198010ggh-stack/awe_ground/傳感器/HKVL-56六維力/使用筆記.md

# HKVL-56 六維力傳感器使用筆記

日期：2026-11-05
來源：《HKVL-56 型六維力傳感器用戶手冊 Ver 1.1》（蘇州航凱微電子，24 頁 PDF，沒有放進倉庫）和官網產品頁 https://www.hkvtech.cn/archives/172/ 。
讀數腳本：[腳本/hkvl56.py](腳本/hkvl56.py)，已經用手冊裏的全部字節例子自檢通過（`python hkvl56.py --selftest`）。

## 0. 我們手上這個：56C，RS485

| 項目 | 力 Fx/Fy/Fz | 力矩 Mx/My/Mz |
|---|---|---|
| 量程 | 300 N | 10 N·m |
| 分辨率 0.03 %FS | 0.09 N | 0.003 N·m |
| 準度 0.5 %FS | ±1.5 N | ±0.05 N·m |
| 重複精度 0.1 %FS | 0.3 N | 0.01 N·m |
| 過載 300 % | 900 N 不壞（只是不壞，不能拿來測） | 30 N·m |

- **實測（2026-11 第一次通電）：是 Modbus-RTU 版**（第 6.2 節），115200，從機地址 1。不問不答，所以 `--raw` 收不到字節是正常的；讀數要加 `--modbus`。
  - USB 轉 485 模塊是 CH340K，在這臺電腦上是 COM7。
  - 腳本輪詢約 197 Hz，沒有 CRC 錯誤。
  - 空載、剛通電（未預熱）時：零點 Fx +0.12、Fy +0.35、Fz +0.14 N，Mx/My/Mz < 0.007 N·m；噪聲標準差 Fx 0.030、Fy 0.020、Fz 0.017 N，力矩 0.0004–0.0006 N·m。
  - Modbus 版有正式的清零命令，`--hw-zero` 可以用（斷電丟失）。
  - 方向測試和已知重物驗證都通過，讀數準確（重物驗證沒有記錄具體數值）。
- **日常使用**：
  1. 通電，等 30 分鐘預熱，傳感器上不加載。
  2. 在 `腳本/` 目錄下運行 `python hkvl56.py COM7 --modbus`，開頭會自動去皮約 1 秒。
  3. 要記錄數據就加 `--csv 文件名.csv`。
  4. Ctrl+C 停止；斷電前先停腳本。
- 腳本默認 `--model 56C`，屏幕上會一直顯示複合負載率，接近 1 就要減載。
- **在臺架上的位置**：串在線末端和水桶之間，工具端朝上接線，固定端朝下掛水桶。這樣只受拉力，Fz 就是線拉力，10 kg 時負載率約 0.11。為什麼不裝在滑輪座下面、吊板尺寸和裝配順序，見 `機械設計/臺架/文檔/臺架設計文檔_2026-10-30.md` 第 9 節；3D 模型裏有「傳感器特寫」視圖。

## 1. 它是什麼

一個 Ø56 × 22.5 mm 的鋁合金圓餅，底面（**固定端**）裝在不動的結構上，頂面（**工具端**）裝要測力的東西。內部是應變片加解耦矩陣，直接輸出 **Fx Fy Fz（N）和 Mx My Mz（N·m）** 六個數，已經是工程單位，不用自己標定。線纜是不可拆的 4 芯屏蔽線。

| 型號 | Fx/Fy/Fz | Mx/My/Mz | CAN 2.0 每 LSB（力 / 力矩） |
|---|---|---|---|
| 56AS | 50 N | 2 N·m | 0.025 N / 0.001 N·m |
| 56A | 100 N | 5 N·m | 0.050031 / 0.0025 |
| 56B | 200 N | 7 N·m | 0.0981 / 0.00345 |
| 56C | 300 N | 10 N·m | 0.14715 / 0.005 |
| 56D | 400 N | 12 N·m | 0.1962 / 0.006 |

共同參數：準度 0.5 %FS，重複精度 0.1 %FS，分辨率 0.03 %FS，過載 300 %FS，工作溫度 −10 ~ 80 ℃，採樣 100 ~ 1000 Hz（可定制），供電 12 ~ 24 VDC，重量 ≤ 0.2 kg。

**手上這個是哪個型號、哪種通訊**要看標籤或問賣家。下面四種協議只有一種是你這個傳感器出廠燒好的。

## 2. 坐標系

- **Fz+**：垂直於端面，從固定端指向工具端（工具端朝上放時就是向上）。
- **Fx+**：指向**出線口**那一側。
- **Fy+**：按右手系，從頂面看 Fx 逆時針轉 90°。
- **Mx My Mz**：繞對應軸，右手定則（大拇指沿軸正方向，四指方向為正）。
- **實測確認（第一次通電，傳感器平放、按住底座推頂面）：**
  - 往下按頂面中心：Fz −5 ~ −15 N（用力按到 −70 N）。
  - 往出線口方向推頂面側面：Fx +8 ~ +11 N。
  - 往和出線口垂直的方向推：Fy −8.5 ~ −9.2 N，說明那次推的是 −Y 方向。
  - 讀數就是「施加在工具端上的力」在傳感器坐標系裏的分量。
  - 側推 Fx 約 10 N 時 My 約 −0.06 N·m，側推 Fy 約 −9 N 時 Mx 約 −0.08 N·m。按 M = r × F 反推，手推的位置在坐標原點下方 6–9 mm，所以**原點大約在頂面（工具端端面）附近**。算滑輪的力臂 h 時從頂面量起。

## 3. 機械安裝

| | 固定端（底面） | 工具端（頂面） |
|---|---|---|
| 螺栓 | 6 × M3×12 內六角，出廠就埋在傳感器裏，從底面 6 個 Ø3.2 孔伸出來，最多伸出 6 mm；你的底座上要有 6 個深於 6 mm 的 M3 螺紋孔 | 6 × M4 螺紋孔，均布在 Ø48 圓上，你的工具用 M4 螺絲擰上來 |
| 定位銷孔 | 2 × Ø4.02 (+0.03/0) 深 5 | 2 × Ø4 深 4 |
| 其他 | 出線口在側面，有壓線塊 | 中間 Ø24 凸臺 |

- M3 內埋螺栓怎麼擰：用 2.5 mm 內六角扳手從**頂面的 M4 螺紋孔**伸進去（手冊圖 4 的擰緊順序就畫在這 6 個孔上）。所以要先把底座擰好，再裝工具端。
- 尺寸圖側視上的「Max 6.00」標在 M3 螺栓伸出底面的那一頭，是螺栓最多伸出 6 mm。
- M4 孔下面就是 M3 螺栓頭，M4 螺絲不能擰深，先按 4 mm 左右算。
- 以上三條是按手冊的圖推斷的。**買螺絲、打印吊板前用卡尺量一下，或者跟賣家要 STEP 模型。**
- 擰螺栓：先把 6 顆全部擰進去不擰緊，再按**對角順序**擰緊（手冊圖 4 是五角星走法：1 右下 → 2 左上 → 3 右 → 4 左 → 5 右上 → 6 左下）。擰不順就換螺栓，不要硬擰。
- 拆裝時傳感器和設備都要斷電。

## 4. 接線

| 線色 | RS485 版 | CAN 版 |
|---|---|---|
| 紅 | VCC 12–24 V | VCC 12–24 V |
| 黑 | GND | GND |
| 黃 | 485-A | CAN-H |
| 綠 | 485-B | CAN-L |

- RS485：USB 轉 485 模塊的 A 接黃、B 接綠，**模塊的 GND 和電源的 GND 接到一起**（線只有 4 芯，信號地就是電源地）。
- USB 轉 485 模塊自己由電腦 USB 供電，不用另外接電。模塊端子上如果有 5V/VCC，**空着不接**，接電池會把電倒灌進電腦 USB 口。
- 線只有一兩米、115200 時，模塊上的 120 Ω 終端電阻跳線接不接都行；讀數不穩再試着接上。
- CAN：傳感器內部**沒有** 120 Ω 終端電阻，接收端要自己加 120 Ω。
- 接線前先摸一下金屬放靜電；接錯線可能燒傳感器，按顏色接。

**用鋰電池供電**（手冊範圍 12–24 VDC；手冊沒寫極限電壓、電流，也沒寫有沒有反接保護）：

| 電池 | 電壓範圍 | 能不能直接接 |
|---|---|---|
| 3S | 9.0–12.6 V | 不行，大部分時間低於 12 V |
| 4S | 12.0–16.8 V | 可以，放到每節 3.0 V 前都在範圍內 |
| 5S | 15.0–21.0 V | 可以，最穩 |
| 6S（捲線器那塊） | 18.0–25.2 V | 不要直接接：充滿超過 24 V；VESC 回收制動時母線還會再往上衝 |

- 要用 6S 的話，中間加一個 DC-DC 降壓模塊到 12 V 或 15 V，最好是隔離型，把電機的干擾和地線上的噪聲擋在外面。
- 更省事的辦法是單獨一塊 4S 小電池，或者用 PD 充電寶加 PD 誘騙板，設成 12 V、15 V 或 20 V。
- 電池插頭（XT30/XT60）接紅黑線時一定量一下極性；串一個 0.5–1 A 保險絲。

**XT60 電池怎麼接到傳感器（不用焊）：**

```
電池 XT60 母頭 ═ XT60 公頭帶線 ─ 紅 ─ 保險絲 1A ─[WAGO 2 孔]─ 傳感器紅
                                └ 黑 ────────────[WAGO 3 孔]─ 傳感器黑
                                                      └──── 短線 → 485 模塊 GND
傳感器黃 → 485 模塊 A；傳感器綠 → 485 模塊 B（直接擰進模塊的螺絲端子）
```

- 要買：XT60 公頭帶線（14–16 AWG 矽膠線）、WAGO 221-412 和 221-413 各一個（或普通 2 孔、3 孔快速接線端子）、線上保險絲座加 1 A 保險絲、一小段 22–24 AWG 導線。
- 傳感器的線頭不要剪，直接插進 WAGO 或擰進螺絲端子。
- 順序：全部接好、萬用表確認紅線對黑線是正電壓之後，**最後才插電池**；拆的時候先拔電池。
- 公頭帶線沒插電池時兩根線頭不要碰在一起；不用時把 XT60 拔開。

## 5. 上電和清零

1. 第一次上電或很久沒用：**通電 30 分鐘預熱**再測。
2. 清零（把當前讀數設為零點）：硬件清零命令見第 6 節，**斷電就丟**，每次上電都要重新做。
3. 零點會漂，要經常清零。腳本默認開機時平均 200 幀做軟件去皮，比硬件清零方便。

## 6. 通訊協議

### 6.1 RS485 主動發送（出廠默認 115200）

上電後自己一直往外發，不用發命令。每幀 28 字節：

```
53 54 | Fx Fy Fz Mx My Mz（6 個 float32，小端）| CRC 低字節 CRC 高字節
```

- CRC 是 CRC-16/MODBUS，算**前 26 字節**（包括幀頭 53 54）。
- 例：`00 00 48 41` = 12.5，`00 00 58 41` = 13.5。
- 手冊沒寫數據位、校驗位，先按 8N1 試。
- 波特率可選 115200 / 460800 / 1M。115200 下一幀 28 字節 × 10 bit，每秒最多約 410 幀；要 1 kHz 得用 460800 以上。腳本顯示的 Hz 就是實際收到的幀率。

### 6.2 Modbus-RTU 主從模式

主機問一次，傳感器答一次。默認地址看手冊例子是 0x01。

| 操作 | 命令（已含 CRC） |
|---|---|
| 讀六維（0x0003 起 12 個寄存器） | `01 03 00 03 00 0C B5 CF` → 回 `01 03 18` + 24 字節（6 個小端 float）+ CRC |
| 只讀 Fx | `01 03 00 03 00 02 34 0B` |
| 清零（寫 0x000E = 0） | `01 06 00 0E 00 00 E8 09`，回包是原樣回顯 |
| 改地址（寫 0x0000） | `01 06 00 00 00 02 08 0B`（改成 2，立即生效）；地址 0x00 是廣播 |
| 改波特率（寫 0x000A） | 值 2=115200，3=460800，4=921600，5=1M；`01 06 00 0A 00 05 69 CB` 是改到 1M |

寄存器：Fx 0x0003，Fy 0x0005，Fz 0x0007，Mx 0x0009，My 0x000B，Mz 0x000D，每個 float 佔 2 個寄存器，字節順序是小端。

### 6.3 CAN-FD

仲裁域 1 Mbps，數據域 1 Mbps（可 5 Mbps）。上電自動發，每幀數據域 32 字節：6 個小端 float（Fx..Mz）+ 4 字節保留 + UINT32 幀序。

### 6.4 CAN 2.0（標準幀或擴展幀）

1 Mbps，上電自動發，**兩幀一組**，每幀 7 字節，兩幀的幀序字節相同：

```
頭幀：[幀序][AA][Fx 12bit][Fy 12bit][Fz 12bit][0000]
數據幀：[幀序][Mx 12bit][My 12bit][Mz 12bit][0000][FF]
```

- 每個分量是 12 位補碼，範圍 −2047 ~ +2047，乘上第 1 節表裏的系數就是 N 或 N·m。
- 例（56AS）：`4C AA 02 20 06 05 20` + `4C 00 5F FD 00 E0 FF` → Fx 0.85 N，Fy 0.15 N，Fz 2.05 N，Mx 0.005，My −0.003，Mz 0.014 N·m。
- 改參數都發到**廣播 ID 0x321**：`74 00 0A` 改 ID 為 0x0A（下次上電生效）；`0E 00` 清零（立即生效，斷電丟）；`14 00` 用標準幀，`14 01` 用擴展幀。

## 7. 複合載荷：別只看單軸量程

幾個分量同時受力時，手冊給的安全判據是：

```
(Fx/Fx,FS)² + (Fy/Fy,FS)² + (Fz/Fz,FS)² + (Mx/Mx,FS)² + (My/My,FS)² + (Mz/Mz,FS)² ≤ 1
```

**大於 1 就算每個單軸都沒超量程，也可能讓彈性體輕微塑性變形，零點永久漂移。** 一個力只要不是正好壓在中心，就會同時帶來力矩，所以力臂越長越容易超。腳本加 `--model 56C` 會實時顯示這個值。

**如果裝在滑輪下面**（臺架上最後沒這樣裝，見第 0 節；以後地面站要測線的方向時可能用到）：滑輪那一側除了傳感器不能再碰桌子或支架，否則力會繞過傳感器。假設傳感器頂面朝上，滑輪軸在頂面上方 h 處，線水平進、豎直往下（轉 90°），線拉力為 T。傳感器受到：Fz = −T（豎直段往下拉，過中心不產生力矩），Fx = T（水平段），My = T × h。代入公式就是 2 × (T/F_FS)² + (T·h/M_FS)²：

| 工況 | 56AS | 56A | 56B | 56C | 56D |
|---|---|---|---|---|---|
| T = 100 N，h = 20 mm | 9.00 | 2.16 | 0.58 | 0.26 | 0.15 |
| T = 100 N，h = 40 mm | 12.00 | 2.64 | 0.83 | 0.38 | 0.24 |
| T = 100 N，h = 60 mm | 17.00 | 3.44 | 1.23 | 0.58 | 0.38 |
| T = 200 N（衝擊），h = 20 mm | 36.00 | 8.64 | 2.33 | 1.05 | 0.61 |
| T = 200 N（衝擊），h = 40 mm | 48.00 | 10.56 | 3.31 | 1.53 | 0.94 |

結論：
- 100 N 工作載荷：56B 在 h ≤ 40 mm 時夠用，但餘量小；56C 比較穩。
- 200 N 衝擊：只有 56D 在 h ≤ 40 mm 時不超；56C 要把 h 壓到 20 mm 以下才勉強接近 1。
- 不管哪個型號，滑輪軸都盡量貼近傳感器頂面。
- 傳感器裝的方向不一樣（比如側裝）時，按實際方向重新分解再代公式。

## 8. 第一次通電試讀（建議步驟）

1. 傳感器平放在桌上，不加載。
2. 接 24 V 電源（紅/黑），USB 轉 485 接黃 A、綠 B，兩邊 GND 接一起。
3. `pip install pyserial`，再用 `python -m serial.tools.list_ports -v`（或設備管理器）找 485 模塊是 COM 幾。
4. 先看原始字節：`python hkvl56.py COM5 --raw`（腳本自帶，相當於串口助手的十六進制顯示，Ctrl+C 停）：
   - 每行都是 `53 54` 開頭、28 個字節 → 正常，主動發送模式，直接 `python hkvl56.py COM5`。
   - 一行行 32 個亂七八糟的字節，找不到 `53 54` → 波特率不對，跑 `python hkvl56.py COM5 --scan` 自動試 4 種波特率，再用 `--baud` 指定。
   - 一個字節都沒有 → 查供電、A/B 對調、GND；或者是 Modbus 版，`--scan` 也會試 Modbus。
   - 想用圖形界面的串口助手：`pip install comtool` 後運行 `comtool`；設置 115200、8 位數據、無校驗、1 停止位，接收選 HEX，不要發送任何東西。
5. 預熱 30 分鐘後重啟腳本，讓它重新去皮。
6. 驗證方向和數值：
   - 頂面朝上，放一個用行李秤稱過的東西，Fz 應約為 −m × 9.81（壓向固定端，所以是負的）。
   - 從側面往出線口方向推頂面，Fx 應為正。
7. 要存數據加 `--csv log.csv`。

## 9. 手冊裏前後不一致或沒寫清楚的地方

- **工具端螺栓數量**：2.1 節文字寫「3 個 M4」，安裝圖和尺寸圖都是 6 個 M4，按 6 個。
- **官網和手冊不一樣**：官網寫重量 ≤ 0.3 kg、供電 24 V、採樣 150–1000 Hz；手冊寫 ≤ 0.2 kg、12–24 V、100–1000 Hz。供電用 24 V 兩邊都滿足。
- **Modbus 例 4**：標題寫「寫入 ID:1」，數據卻是 `00 02`，實際寫進去的是 2。
- **RS485 主動發送模式**沒寫怎麼清零，也沒寫數據位、校驗位。腳本用軟件去皮；`--hw-zero` 會發 Modbus 清零幀試試，有沒有用看讀數。
- **主動發送和 Modbus 能不能切換**手冊沒寫，應該是出廠固件決定的，問賣家。
- **4.3 節的 Python 示例代碼有 bug**：幀頭不對時不丟字節，會死循環；用了沒定義的變量 `data`；緩衝區超過 28 字節時 `receive_buffer[:-2]` 取錯範圍。不要照抄，用 `腳本/hkvl56.py`。

## 10. 維護

- 經常往復運動的話，定期檢查螺栓有沒有鬆、線纜有沒有磨破。螺栓鬆了斷電換新的。
- 髒了斷電後用酒精棉簽擦。避免高溫高濕、灰塵、液體、溫度劇變。
- 不要敲、不要摔、不要拆。經常用到滿量程的話，定期返廠標定。
- 保修 12 個月（從發貨日算）。售後：Support@hkvtech.cn，13801597531。

## 11. 在 Jetson NX 上運行（不接電腦）

接線不變：USB 轉 485 模塊從電腦換插到 NX 的 USB 口，傳感器照樣單獨 12–24 V 供電，485 模塊的 GND 照樣接傳感器電源負極。腳本支持 Python 3.6 以上，JetPack 4/5/6 自帶的 python3 都能跑。

**我們這臺 NX（2026-11-06 查的）：** JetPack 6，L4T R36.4.4，內核 5.15.148-tegra，用戶 nvidia。這版內核**沒帶 CH340 驅動**（`modinfo ch341` 報 not found），所以 `lsusb` 能看到 `1a86:7522 QinHeng`，卻沒有 `/dev/ttyUSB0`。要先裝驅動。

**一次性設置：**

1. 拷文件：先在 NX 上 `hostname -I` 查 IP，再在 Windows PowerShell 裏進到 `傳感器\HKVL-56六維力\腳本` 目錄：
   `scp hkvl56.py nx_install_ch341.sh nvidia@NX的IP:~/`
2. 在 NX 上裝驅動：`bash ~/nx_install_ch341.sh`（不要加 sudo，中途會要密碼）。
   - 腳本從 kernel.org 下載和內核同版本（v5.15.148）的 `ch341.c`，編譯成 `ch341.ko`，裝到 `/lib/modules/5.15.148-tegra/extra/`，以後插上自動加載。
   - 順便把用戶加進 dialout 組，沒有 pyserial 的話一起裝上。
   - **apt 升級 L4T 內核以後（`uname -r` 變了）要重新跑一次。**
   - 2026-11-06 在這臺 NX 上實際跑通：出現 `/dev/ttyUSB0`，固定名字是 `/dev/serial/by-id/usb-1a86_USB_Serial-if00-port0`。
3. 退出重新登錄（SSH 斷開重連），dialout 權限才生效；`groups` 裏有 dialout 才算好。只想在當前終端先用，可以 `newgrp dialout`。
4. 拔插一次 485 模塊，看串口：`ls /dev/ttyUSB* /dev/serial/by-id/`，應該有 `/dev/ttyUSB0`。
   - 插上一下就消失、`sudo dmesg` 裏有 `brltty`：盲文屏幕閱讀器搶了串口，`sudo apt remove brltty` 後重插。
5. 自檢：`python3 ~/hkvl56.py --selftest`。

**日常運行：**

- `python3 ~/hkvl56.py /dev/ttyUSB0 --modbus`；記錄數據加 `--csv ~/force.csv`（同名文件會被覆蓋）。
- 串口名用 `/dev/serial/by-id/` 下面那個長名字更穩：插別的 USB 串口設備時 `ttyUSB0` 可能變成 `ttyUSB1`，by-id 的名字不變。
- 不接顯示器、SSH 斷了也不停：先 `tmux new -s ft` 再運行；按 Ctrl+B 再按 D 脫離，之後 `tmux attach -t ft` 回來看。沒有 tmux 就 `sudo apt install tmux`。
- 預熱照樣要 30 分鐘；開機自啟時傳感器剛上電，去皮不準，預熱完重啟腳本。

**在自己的程序裏用（NX 上做計算）：** 把 `hkvl56.py` 放在同一目錄，

```python
import serial, hkvl56
ser = serial.Serial("/dev/ttyUSB0", 115200, timeout=0.05)
it = hkvl56.stream(ser, modbus=True)   # 約 200 Hz
zero = hkvl56.tare(it, 200)            # 空載平均 200 幀做零點
for raw in it:
    fx, fy, fz, mx, my, mz = (a - b for a, b in zip(raw, zero))
    # 在這裏算線拉力、寫日誌、發給別的程序……
```
