198010ggh-stack/awe_ground/機械設計/捲線器/文檔/地面手拉測試_2026-11-06.md

# 捲線器地面手拉測試

日期：2026-11-06
範圍：把捲線器放在地上、由人手拉線，給它一個可控的負載，用來標定「電流 → 線拉力」和試測試用的 lisp。代替原來的桌邊臺架（臺架暫不搭建，設計保留在 `機械設計/臺架/`）。捲線器本體見 `捲線器設計文檔_2026-10-20.md`，六維力傳感器見 `傳感器/HKVL-56六維力/使用筆記.md`。

演示：`手拉測試_網頁3D模型.html`（放線 / 8 字飛行 / 收線三種模式切換，實時顯示電流、拉力、線速和功率）；放線模式的動圖 `手拉測試動圖_放線.gif`。

## 1. 和臺架有什麼不同

| | 臺架（不做了） | 地面手拉 |
|---|---|---|
| 負載 | 水桶，重量固定、已知 | 人手，拉力隨人變 |
| 行程 | 約 0.3 m | 5–10 m（放出多少線就有多少） |
| 拉力讀數 | 已知重量 / 行李秤 | 串在線上的六維力傳感器或行李秤 |
| 最大的危險 | 水桶被拉到頂 | **人一鬆手，捲筒加速收線，手柄飛回來** |

所以手拉測試的安全全靠三樣東西：**低電流上限、最高轉速限制、手邊的急停**。三樣都設好之前不要拉。

## 2. 場地和固定

### 2.1 擺放

- 平整的地面，捲線器前方 10 m 長、1 m 寬的通道裏沒有人和雜物。
- 光軸**垂直於**拉線方向，拉線的人站在**捲筒中間的正前方**。沒有排線機構，人一偏，線就堆到捲筒一邊，會蹭擋板邊緣。
- 線**從捲筒下方出來**（離地 59.5 mm），比從上方出來（離地 150 mm）掀翻力矩小一半多。

### 2.2 固定（必須做）

線水平拉捲筒時，會把捲線器往人這邊**拖**，還會往前**掀**：

| 電流 | 線拉力（按 4 N/A 估） | 拖動力 | 掀翻力矩（線高 59.5 mm） |
|---|---|---|---|
| 5 A | 約 20 N | 20 N | 1.2 N·m |
| 25 A | 約 100 N | 100 N | 6 N·m |

捲線器約 4.4 kg：
- 放在地上靠摩擦只能擋住約 17 N 的拖動力，5 A 就快拖動了。
- 重心在前面那根型材外緣後面約 50 mm，自重只能抵約 2.2 N·m 的掀翻力矩。

所以要做兩件事：

1. **防拖動**：用綁帶把兩根型材的後端綁在身後一個重而穩的東西上，比如工作臺的腿或重櫃子。綁帶方向和拉線方向相反，拉緊。
2. **防掀翻**：在電機下面的兩根型材上壓約 10 kg 的東西，比如一摞書或一桶水，放在電機下面的空當裏，別碰到轉子。25 A 時要多抵 3.8 N·m，按 50 mm 力臂需要約 8 kg，10 kg 有餘量。

### 2.3 手的高度

- 線往上斜拉會把捲線器前端往上抬，掀翻力矩更大。
- 拉線的人站在 3 m 以外，手放低，先拉在膝蓋高度，讓線和地面的夾角保持在 20° 以內。

## 3. 線、手柄和拉力讀數

### 3.1 線

- 只放出 5–10 m。捲筒上至少留 3 圈，線頭穿過擋板上的 Ø3 孔打結。
- 測試前檢查線有沒有磨損、打結。

### 3.2 手柄

- 線末端用單套結拴一根木棍當手柄，比如 Ø25 × 300 mm 的木棍或掃把柄。
- **不要把線纏在手上或手指上**。Dyneema 很細很滑，受力時會勒進肉裏。
- 拉線的人戴手套和護目鏡。

### 3.3 拉力讀數：六維力傳感器（推薦）

把臺架設計裏做好的上、下吊板直接拿來用，串在線和手柄之間：

```
線（單套結）→ 上吊板吊耳 → HKVL-56C → 下吊板吊耳 → S 鉤 → 手柄
```

- **線拉力就是 Fz**：只受拉力，Fz 方向從固定端指向工具端。量程 300 N，100 N 時負載率約 0.11；過載 900 N 不壞。
- **傳感器的線纜要留鬆弛**：用紮帶在手柄上固定一段，讓拉力全部走傳感器，不走線纜。
- **電腦和 24 V 電源放在拉線的人身邊**：傳感器線纜長度有限。RS485 可以接長到幾十米，也可以把電腦放在中間。
- **讀數**：在 `傳感器/HKVL-56六維力/腳本/` 下運行 `python hkvl56.py COM7 --modbus`（COM 口以設備管理器為準）。開頭會自動去皮約 1 秒，這時線一定要鬆着。
- 吊板孔位按 Ø48 圓 6 等分估的，打印前先用卡尺核對傳感器，見臺架設計文檔第 9.3 節。

### 3.4 拉力讀數：行李秤（沒有傳感器時）

- 行李秤串在線和手柄之間，只能在人站住不動時讀數。

## 4. VESC 設置（每次測試前確認）

| 參數（VESC Tool 裏的名字） | 設多少 | 為什麼 |
|---|---|---|
| Motor Current Max | 先 3–5 A，以後最多 25 A | 限制最大拉力，3–5 A 約 12–20 N |
| Motor Current Max Brake | 和上面同樣大小 | 人往外拉線時電機在制動 |
| Battery Current Max / Max Regen | 例如 +10 A / −5 A | 往外拉線時電機發電，電流倒灌回電池 |
| Max ERPM | 210 × 電機極對數 | 把線速限制在約 1 m/s（捲筒約 210 rpm）。28 極的電機是 14 對極，約 2940 |
| 電機方向 | 正電流 = 收線 | 反了就在 VESC Tool 裏反轉電機方向，不要改接線 |

- **只用 VESC Tool 手動給電流**，在底部的 Current 輸入框裏輸入。
- **原版的 `vesc-code.lisp` 和 `vesc-code_test.lisp` 都不要刷**，它們在沒有拉力時會一直收線。
- FOC 參數檢測要先做完（捲線器設計文檔第 8 節）。

## 5. 人員分工和口令

- **操作員**：守着電腦和急停。急停是串在電池線上的 XT60 防打火開關。
- **拉線的人**：戴手套和護目鏡，只按口令動作。
- **其他人**：站在捲線器後面或側面，不要站在線的延長線上，也不要跨過線。

口令統一，每一步都等對方回應：

| 口令 | 誰說 | 意思 |
|---|---|---|
| 拉緊 | 操作員 | 拉線的人把線拉直、站穩，回「好」 |
| 給電 X 安 | 操作員 | 輸入 X A |
| 放 / 收 | 操作員 | 拉線的人慢慢後退（放線）或前進（收線），全程保持線是緊的 |
| 零 | 操作員 | 電流設 0。**拉線的人只有聽到「零」之後才能鬆手** |
| 停 | 任何人 | 操作員立刻斷急停 |

## 6. 測試步驟

### 6.1 首次通電（不接線）

1. 斷開線，捲筒上不拴線，或者線全部繞好、線頭固定。
2. 做 FOC 參數檢測。
3. 用 ≤ 2 A 低速轉動：看同心度、聽有沒有異響、看頂絲有沒有鬆，確認正電流是收線方向。
4. 設好第 4 節的限制，特別是 Max ERPM。手撥捲筒轉一下，確認轉速被限住。

### 6.2 1 A 手拉

1. 拴好線和手柄（帶傳感器的話先去皮）。拉線的人走到 3 m 外，把線拉直。
2. 「給電 1 安」：拉線的人感到一個穩定的拉力，約 4 N。
3. 「放」：慢慢後退 2–3 m，線被拉出，電機在制動、發電。
4. 「收」：慢慢往前走，讓電機把線收回來，線始終保持緊的。
5. 「零」，然後再鬆手。

### 6.3 逐步加大

- 每檔手感正常、捲線器沒動、沒有異響，就按 2 A → 3 A → 5 A 往上加。
- 加到 5 A 以上前，先把 Motor Current Max 調高，並再確認一遍固定（第 2.2 節）。
- 每次加檔後，看一眼油漆筆畫的記號線（頂絲、螺母、法蘭）有沒有錯開，立板根部有沒有發白。

### 6.4 標定：電流 → 線拉力

**靜態（主要用這個）**
1. 拉線的人站住不動，線拉直。
2. 操作員依次給 2、4、6 … A，每檔停 3–5 秒。
3. 記錄這段時間 Fz 的平均值；用行李秤時讀穩定的讀數，kg × 9.81。
4. 填第 8 節的表，擬合 T = k × I + b。
   - k 預計 3.6–4.2 N/A（捲線器設計文檔和臺架設計文檔第 6.3 節有推算過程）。
   - Kt = k × 0.0455 m，捲筒上只有幾圈線時用這個半徑。

**看摩擦（有傳感器時）**
1. 固定一個電流（比如 3 A）。
2. 拉線的人以差不多的速度慢慢「放」一段，再「收」一段。
3. 放線時 Fz 比收線時大，兩者差值的一半就是傳動摩擦。原版降落時最低只給 1.7 A，摩擦大了低拉力就控制不准，所以要知道它有多大。

### 6.5 測試用 lisp（以後）

在同樣的條件下試：先 3–5 A、Max ERPM 限住，再逐步放開。lisp 裏要有按線長和線速的保護。

## 7. 什麼情況立刻停

- 拉線的人手滑、摔倒，或者線纏到東西。
- 捲線器被拖動或前端翹起。
- 有異響，記號線錯開（頂絲或螺母鬆了），立板根部或螺栓孔周圍發白、開裂。
- 電機或 VESC 燙手。
- 每次測試結束都要斷開電池。

## 8. 記錄表

| 日期 | 電流 I (A) | 拉力 Fz (N) | 拉力來源（傳感器 / 行李秤） | 放線 / 收線 / 靜止 | 備註 |
|---|---|---|---|---|---|
| | | | | | |
