198010ggh-stack/awe_ground/機械設計/捲線器/文檔/捲線器設計文檔_2026-10-20.md

# 地面站捲線器設計：直驅 + 聯軸器 + 獨立捲筒軸

日期：2026-10-20
範圍：電機與捲線筒的機械連接（捲線器本體）。VESC 配置、lisp 參數、臺架測試架、排線機構不在本文範圍內，另行設計。

## 1. 目標與約束

| 項目 | 取值 |
|---|---|
| 對標 | 原版 KitesForFuture Trampa 165Kv 配置：線拉力係數 ≈ 3.97 N/A，23 A 時約 90 N |
| 電機 | 80100 外轉子，**Kv 50**，Ø12 D 型軸，軸伸出 40 mm（削平段 29 mm），重 1.63 kg |
| 電機安裝 | 定子安裝面與出軸**同側**，4 × M5，孔距圓 **Ø56** |
| 電池 | 現階段 6S；以後上天建議換 12S（結構不受影響） |
| 線 | Dyneema 編織線 Ø1.0 mm，破斷力約 1000 N；現階段 50 m，捲筒容量按 300 m 設計 |
| 工作載荷 | 線拉力 100 N；按 200 N（2 倍衝擊）校核 |
| 加工條件 | 3D 打印（**只有 PLA**）+ 網購標準件；不需要車、銑、鑽 |

## 2. 方案概述

電機直驅，不用減速。電機軸經梅花聯軸器帶動一根 Ø15 捲筒軸。捲筒軸由兩個 KFL002 法蘭軸承支撐，軸承裝在 3D 打印的立板上。

**為什麼直驅**：Kv 50 電機的轉矩常數 Kt ≈ 9.55/50 ≈ 0.19 N·m/A。配上平均有效捲徑 Ø93，線拉力係數 ≈ 0.19 / 0.0465 ≈ **4.1 N/A**，和原版的 3.97 N/A 幾乎一致。如果加 3:1 減速，拉力係數會到約 13.8 N/A，6S 下最大收線速度只有約 1.6 m/s，不可用。

**受力路徑**：
- 線拉力 → 捲筒 → Ø15 軸 → 兩個 KFL002 → 軸承立板 → 鋁型材底座。**電機軸承不承受線拉力。**
- 扭矩 → 捲筒 → 驅動側擋板 → 抱緊式法蘭聯軸器 → Ø15 軸 → 梅花聯軸器 → 電機軸。

## 3. 佈局

所有軸心高度統一取 **H = 85 mm**（從型材頂面量起）。依據：擋板半徑 70 mm + 15 mm 離地間隙；電機半徑 39.5 mm，在這個高度下方留有餘量。

```
側視（沿軸向，x = 0 為電機定子安裝面）
                  立板A(電機)    立板B(軸承1)                       立板C(軸承2)
 ┌──────────┐      ┃  ┌──────┐   ┃[KFL]  [法蘭]┏━┓━━━━━━━━━━━━━━┏━┓  [KFL]┃
 │  80100   ├──────╂──┤聯軸器 ├───╂═══════════════┫ ┣  Ø90 鋁管 L68  ┫ ┣═══════╂══
 │ 轉子殼(轉)│      ┃  └──────┘   ┃              ┃擋┃←4×M5 螺桿→   ┃擋┃       ┃
 └──────────┘      ┃              ┃              ┗━┛━━━━━━━━━━━━━━┗━┛       ┃
 ════════════════ 兩根 2020 鋁型材（長 400 mm）══════════════════════════════════
```

各零件沿軸向的大致位置（x 從電機定子面量起，單位 mm；最終以實物和 CAD 為準）：

| 零件 | x 範圍 |
|---|---|
| 立板 A（電機座，厚 10） | 0 – 10 |
| 電機軸 | 0 – 40 |
| 梅花聯軸器 | 約 14 – 80（隨所買型號的長度變化） |
| 捲筒軸 | 約 56 – 256，長 **200** |
| KFL002 + 立板 B | 約 81.5 – 110（立板 100 – 110；KFL002 內圈伸出 18.5，離聯軸器 1.5 mm） |
| 法蘭輪轂 + 捲筒（含擋板） | 約 120.6 – 209（法蘭盤在鋁管內 141 – 147，輪轂穿過驅動側擋板伸到 120.6） |
| 立板 C + KFL002 | 約 226.5 – 255（立板 226.5 – 236.5；給拉桿螺母和 M6 螺絲頭留間隙，見 4.1、4.4） |

出線方向朝前（垂直於軸），捲筒前方留空，以後裝排線舵機臂和導向環（沿用原版機構，另行設計）。

## 4. 零件設計

### 4.1 立板（共 3 塊，A / B / C）

- 共用一個基礎外形：寬 120 mm，高 H + 40 = 125 mm，厚 10 mm。底部帶 L 形腳板和兩條三角加強筋。腳板上開 2 個 Ø5.5 長孔（每根型材上方一個，可沿軸向調 ±3 mm），用 **M5 × 16** 內六角螺絲 + **M5 加大墊片 + M5 平墊片**（兩片疊用，當墊高）+ 20 系列 M5 T 型螺母（錘頭或彈片式）固定到 2020 型材上。螺絲尖約在型材表面下 5.6 mm，擰進 T 型螺母約 3.8 mm，又不會頂到槽底。
- **打印方向**：兩種都可以。PLA，8 圈壁，60% gyroid 填充，頂底各 6 層。
  - **立着打（推薦，腳板貼平台，和使用時方向一樣）**：佔地 120 × 45，一盤能擺多塊。腳板和立板的連接處在層內，比平放結實。孔變成水平的：Ø40 / Ø36 中心孔頂部會略下垂（只是讓位孔，不影響）；Ø5.5 / Ø6.5 螺絲孔可能略小，螺絲穿不過就用同尺寸鑽頭手擰鉸一下。**不要開支撐**，否則中心孔裏會長滿支撐。
  - 平放（板面貼平台）：佔地 120 × 125；貼電機 / 軸承的那面最平，但腳板和立板的連接處變成層間粘合，是最弱的地方。
- 強度校核：出線垂直於軸、水平朝前，線拉力沿板面方向。200 N 作用在 85 mm 高處，板根彎矩約 17 N·m，10 × 120 截面沿板面彎曲的應力只有約 0.7 MPa。即使線完全從側面拉（極端情況），加上兩條筋板後板根應力約 2.7 MPa，立着打時也遠低於 PLA 層間強度（一般 15–25 MPa）。

**PLA 的三個弱點和對策**（見 4.5 節）：怕熱（約 55 °C 開始變軟）、受恆定載荷會蠕變、受衝擊易脆裂。

**立板 A（電機座）**
- 中心孔 Ø`BOSS_D` = **Ø40**，讓過出軸、中心軸承和定子面上的 4 顆內六角螺絲頭（按電機尺寸圖：孔距約 Ø28、頭約 Ø7，外包絡約 Ø35）。孔邊到 Ø56 安裝孔還剩約 5 mm 料，不用再量實物。
- 4 個 **Ø5.5** 通孔，在 Ø56 孔距圓上，用 M5 螺絲固定電機。
- 板面和轉子殼之間保證 ≥ 2 mm 間隙。只有定子面接觸立板。

**立板 B、C（軸承座）**
- 中心孔 Ø36，讓過 KFL002 的軸承凸台。
- 2 個 Ø6.5 通孔，間距 53 mm，固定 KFL002。
- **緊固件**：M6 × 25 螺絲（推薦外六角，頭高約 4；內六角頭高 6 也可），螺絲頭下墊 M6 平墊片，**從朝捲筒的一面穿入**；M6 普通螺母擰在 KFL002 法蘭那一側（金屬面不用墊片），塗中強度螺紋膠，螺桿伸出螺母約 1.7 mm。
  - 間隙：立板 C 朝捲筒的一面凸出 6 mm 的螺絲頭，必須避開旋轉的拉桿螺母，所以立板 C 外移到 226.5 mm（見 4.4）。立板 B 那側間隙足夠。
- B 板上的 KFL002 裝在朝聯軸器的一面，C 板上的裝在外側面，這樣兩個軸承都在捲筒外側，留出空間給捲筒。

### 4.2 聯軸器

- 梅花聯軸器（鋁合金爪 + 聚氨酯梅花墊），外徑約 D40，孔徑 **12 mm × 15 mm**，頂絲固定型。
- 額定扭矩 ≥ 10 N·m（工作約 4.2 N·m，衝擊約 8.4 N·m）。
- 12 mm 端的頂絲必須壓在電機軸的 D 型削平面上；15 mm 端的頂絲壓在捲筒軸的削平面上。
- 用一個 3D 打印的防護罩蓋住聯軸器，固定在立板 A 和 B 之間的型材上。

### 4.3 捲筒軸

- Ø15 鍍鉻光軸（GCr15），長 200 mm，**整根單邊削平**（削深 1 mm 左右，按店家標準）。
- 兩個 KFL002 用自帶的頂絲鎖住軸，同時限制軸向竄動。
- 撓度校核：軸承跨距約 145 mm，中點受 200 N 時撓度約 0.02 mm，可以忽略。

### 4.4 捲筒

- **芯管**：6061 鋁管，外徑 Ø90，壁厚 3 mm，長 **68 mm**（實測），兩端去毛刺。鋁管承受捲線產生的徑向壓力，打印件不承受。
- **擋板**（2 塊，PLA 打印）：
  - 外徑 Ø140，厚 8 mm。PLA，8 圈壁，60% 填充。打印時槽口朝上（避免第一層外擴把槽口擠窄）。
  - 中心孔：**從動側 Ø15.2**（套在軸上定心，公差片已驗證能順滑通過光軸；AB 膠固化時把捲筒套在光軸上，保證兩端同心）；**驅動側 Ø35.4**（讓法蘭 Ø35 輪轂穿過，並靠輪轂定心，公差片已驗證）。
  - 驅動側另有 **3 × Ø5.5** 法蘭螺栓孔，孔距圓 Ø47.5，對準法蘭上 Ø47.5 那組孔。
  - 內側有一圈環形槽：內徑 83.6、外徑 90.4、**深 4 mm**（槽底剩 4 mm），鋁管兩端插進去。兩塊擋板內側面之間的淨捲線寬度 = 68 − 2 × 4 = **60 mm**。
  - 4 個 Ø5.5 孔，在 Ø70 孔距圓上，給 M5 拉桿用。
  - 1 個 Ø3 的拴線孔，在半徑 48 mm 處（緊貼管面外側）。
- **拉緊**：4 根 M5 304 不鏽鋼全牙螺桿，長 **95 mm**，從管子內部穿過兩塊擋板，兩端各加 1 個 M5 加大墊片（外徑約 15、厚約 1.2）和 1 個 **M5 尼龍防鬆螺母**（厚約 5）。螺母擰緊到擋板剛好夾緊鋁管、不明顯壓陷為止，螺桿兩端伸出螺母各約 3.3 mm，**兩端要一樣長**（見下面的間隙）。
  - 長度計算：兩塊擋板外側面相距 76 mm，加兩端各（墊片 1.2 + 螺母 5 + 伸出 2）= 約 92.4 mm，取 95 mm（每端實際伸出約 3.3 mm）。
  - **間隙**：拉桿螺母、墊片和螺桿端頭隨捲筒旋轉，不能碰到不動的立板 C 和它上面凸出的 M6 螺絲頭。所以立板 C 比最初佈局往外挪約 11.5 mm（朝捲筒面在 226.5 mm 處，見第 3 節）：
    - 拉桿螺母（到 215.2 mm）距 M6 螺絲頭頂（220.5 mm）約 5.3 mm；
    - 螺桿端頭（到 218.5 mm，半徑 32.5–37.5 mm）和螺絲頭（半徑 21.5–31.5 mm）在徑向錯開約 1 mm，不會相碰；
    - KFL002（A0 = 18.5）跟着外移後，內圈末端到軸端只剩約 **1 mm**，裝配時確認內圈的頂絲壓在軸上。
- **防轉（必須做）**：PLA 在恆定夾緊力下會蠕變，螺桿的預緊力會慢慢鬆掉，所以不能只靠摩擦傳扭。**環形槽裏必須塗 AB 膠（環氧樹脂）**，把鋁管和兩塊擋板粘成一體。螺桿只負責定位和輔助夾緊。
- **傳扭**：用標準件「大扭矩法蘭聯軸器－抱緊式」Ø15 孔（法蘭盤 Ø56.8 × 6，輪轂 Ø35，總長 26.4，M4 抱緊螺絲），**反裝**：
  - 法蘭盤放在鋁管裏，用**輪轂那一面**貼住驅動側擋板內側；輪轂穿過擋板的 Ø35.4 中心孔，伸出擋板外側約 12.4 mm，末端離立板 B 約 10.6 mm。這樣 200 mm 的光軸不用加長。
  - 3 顆 **M5 × 25 內六角螺栓**（304）：頭在鋁管裏，穿過法蘭盤 Ø47.5 那組孔和擋板；擋板外側加 M5 平墊片 + M5 尼龍防鬆螺母，以後從外面能檢查螺母鬆緊。**注意**：粘好鋁管後螺栓頭在裏面按不住，擰外面的螺母時螺栓會跟着轉，所以塗膠前先用一點 AB 膠把三顆螺栓頭粘在法蘭盤上。
  - 抱緊螺絲在擋板外側（按商品剖視圖量得，中心距法蘭盤輪轂側端面約 14.1 mm，螺絲頭在擋板外約 2.6 mm），整機裝好後轉動捲筒，還能從側面用內六角扳手擰。軸的**削平面對準抱緊切縫**，抱緊時接觸面最大。孔裏的鍵槽不用。
  - 另一塊擋板只套在軸上定心，不傳扭。
  - **裝配順序**：M5 × 25 的頭在鋁管裏面，必須在塗膠裝鋁管**之前**，先把法蘭和驅動側擋板用螺栓穿好、擰緊。
- **容量**：
  - 50 m 線：捲完外徑約 Ø96，平均有效捲徑約 **Ø93**，捲徑變化約 ±3%。
  - 300 m 線：捲完外徑約 Ø120，Ø140 的擋板還剩約 10 mm 邊。

### 4.5 PLA 打印件的使用限制

| 弱點 | 風險 | 對策 |
|---|---|---|
| 怕熱，約 55 °C 開始變軟 | 立板 A 貼着電機定子面，電機發熱會傳過來；夏天陽光直曬，深色件也會超過 50 °C | 用白色或淺色 PLA；手摸電機殼感覺燙（超過約 50 °C）就停機冷卻；臺架階段電流本來就小，問題不大。**上天前把立板 A 換成鋁板**（外包激光切割 5 mm 鋁板） |
| 蠕變 | 螺栓預緊力隨時間下降，擋板和鋁管之間打滑 | 擋板和鋁管用 AB 膠粘死；所有螺栓加大墊片，分散壓力；每次使用前檢查螺母鬆緊 |
| 脆，受衝擊易裂 | 線拉力突變（陣風、急停）時，立板根部或螺栓孔開裂 | 加強筋取厚 8 mm；螺栓孔周圍靠 8 圈壁加厚；臺架測試時逐步加大電流，每次測完檢查有沒有白痕或裂紋 |

### 4.6 底座

- 兩根 **2020** 鋁型材，各長 400 mm，中心距 80 mm（兩根之間淨空 60 mm）。三塊立板的腳板都橫跨兩根型材，本身就把它們連成一體；兩端可再各夾一根 60 mm 長的 2020 短橫樑，用 20 系列角碼固定，增加剛度（臺架階段可不裝）。
- 臺架階段用 G 字夾把底座固定在桌上；野外使用時再設計地錨接口（不在本文範圍）。

## 5. 採購清單（BOM）

| # | 零件 | 規格 | 數量 | 淘寶搜索關鍵詞 |
|---|---|---|---|---|
| 1 | 電機 | 80100 Kv50 | 1 | （已有） |
| 2 | 鋁管 | 6061，外徑 90 × 壁厚 3，長 68 mm（已到貨實測） | 1 | 6061 鋁管 90×3 零切 |
| 3 | 光軸 | Ø15 GCr15 鍍鉻，長 200，整根單邊削平 | 1 | 15mm 光軸 削平 定制 |
| 4 | 法蘭軸承 | KFL002（孔徑 15） | 2 | KFL002 菱形軸承座 |
| 5 | 梅花聯軸器 | D40 左右，孔徑 12 × 15，頂絲型 | 1 | 梅花聯軸器 D40 12-15 頂絲 |
| 6 | 抱緊式法蘭聯軸器 | 孔徑 Ø15，法蘭盤 Ø56.8 × 6，輪轂 Ø35，總長 26.4；額定扭矩請確認 ≥ 15 N·m | 1 | 大扭矩法蘭聯軸器 抱緊式 15mm |
| 7 | 全牙螺桿 | M5 304 不鏽鋼，長 95 mm | 4 | M5 全牙螺桿 304 |
| 8 | 2020 鋁型材 | 400 mm × 2；短橫樑 60 mm × 2（可選） | 2–4 | 2020 歐標鋁型材 零切 |
| 9 | 角碼 | 20 系列（裝短橫樑時用） | 4–8 | 2020 角碼 |
| 10 | T 型螺母 | 20 系列 M5，錘頭或彈片式 | 約 20 | 2020 錘頭螺母 M5 |
| 11 | M5 螺絲 + 平墊片 | **統一用 M5 × 16 內六角**（304），用墊片調節：電機座 4 顆、立板固定 6 顆，各配平墊片；角碼一般隨附自己的螺絲 | 約 12 顆 + 墊片 12 片 | M5 內六角 16 304、M5 平墊片 |
| 12 | M6 螺絲 + M6 平墊片 + M6 螺母 | M6 × 25 **外六角**，固定 KFL002（捲筒裝上後螺絲頭前只剩 5–11 mm，內六角扳手伸不進去，開口扳手可以） | 4 套 | M6 外六角 25 304、M6 平墊片、M6 螺母 |
| 13 | M5 內六角螺栓 + 平墊片 + 尼龍防鬆螺母 | M5 × 25，304，固定法蘭和驅動側擋板 | 3 套 | M5 內六角 25 304 |
| 14 | M5 尼龍防鬆螺母 + M5 加大墊片 | 拉桿用，304；加大墊片外徑 **≤ Ø15**（和法蘭螺栓的墊片只差約 1 mm） | 8 套 | M5 尼龍防鬆螺母、M5 加大墊片 |
| 15 | PLA 耗材 | 白色或淺色，1 kg（全部打印件實心約 0.97 kg，按 8 圈壁 60% 填充約 0.7–0.8 kg） | 1 | （已有） |
| 16 | Dyneema 線 | Ø1.0 mm，≥ 50 m | 1 | 大力馬 PE 編織線 1.0mm |
| 17 | AB 膠 | 環氧樹脂，固化時間 ≥ 5 分鐘 | 1 | 環氧 AB 膠 |

3D 打印件：立板 A ×1、立板 B/C ×2（同一個模型）、擋板 ×2（從動側中心孔 Ø15.2；驅動側中心孔 Ø35.4，另有 3 個法蘭螺栓孔）、聯軸器防護罩 ×1（未設計）。

### 5.1 緊固件總表（全部 304 不鏽鋼）

| 裝配位置 | 螺絲 / 螺桿 | 墊片 | 螺母 | 套數 |
|---|---|---|---|---|
| ① 電機 → 立板 A（Ø56 孔距，擰進電機螺孔） | M5 × 16 內六角 | M5 平墊片 ×1（按電機孔深增減） | — | 4 |
| ② 立板 A/B/C 腳板 → 2020 型材 | M5 × 16 內六角 | M5 加大墊片 + M5 平墊片（疊用） | 20 系列 M5 錘頭 T 型螺母 | 6 |
| ③ KFL002 → 立板 B、C | M6 × 25 外六角，從朝捲筒一面穿入；**先把 KFL002 裝到立板上再裝捲筒**（捲筒裝上後 25 mm 長的螺絲穿不進去） | M6 平墊片（墊在螺絲頭下，PLA 側） | M6 螺母，擰在 KFL 法蘭側，塗螺紋膠 | 4 |
| ④ 捲筒拉桿（穿過兩塊擋板） | M5 全牙螺桿 L95 | M5 加大墊片（外徑 ≤ 15），每端 1 片 | M5 尼龍防鬆螺母，每端 1 個 | 4 根 |
| ⑤ 抱緊式法蘭 → 驅動側擋板 | M5 × 25 內六角，頭在鋁管內 | M5 平墊片（擋板外側） | M5 尼龍防鬆螺母（擋板外側） | 3 |
| ⑥ 角碼（可選） | 隨角碼套裝 | — | 隨套裝 | — |

隨零件附帶、不用另買：抱緊式法蘭的 M4 抱緊螺絲、梅花聯軸器的抱緊螺絲、KFL002 的鎖軸頂絲。另備中強度螺紋膠（樂泰 243 或同類）。

## 6. 裝配前需要量測並寫回 CAD 的參數

這些參數在 CAD 模型裏做成變量，默認值如下。拿到實物後量一下再出 STL：

| 參數 | 默認值 | 量什麼 |
|---|---|---|
| `BOSS_D` | 40 mm ✔ | 按電機尺寸圖取定：定子面 4 顆內六角螺絲頭外包絡約 Ø35，取 Ø40 留足餘量，不用再量 |
| `MOTOR_SCREW_DEPTH` | 6 mm | 電機 M5 螺孔的深度。**擰太深可能碰到線圈**。統一用 M5 × 16：擰入深度 = 16 − 10（立板）− 墊片厚度，要 ≥ 4 mm 且比孔深少 0.5 mm 以上，用墊片片數來調 |
| 法蘭抱緊螺絲位置 | 約 14.1 mm ✔ | 商品剖視圖量得，滿足 **≥ 12 mm**；輪轂 Ø35、總長 26.4、孔距已按商品圖核對；擋板用法蘭上 Ø47.5 那組孔（已確定） |
| `KFL_SPACING` | 53 mm ✔ | 已按賣家尺寸表確認（J = 53，孔 N = 7，M6） |
| `KFL_BOSS_D` | 36 mm ✔ | 賣家圖：背面（安裝面）平，不凸出；A = 13、A0 = 18.5、法蘭厚 6.5 |
| `TUBE_OD` / `TUBE_ID` / 長度 | 90 / 84 / 68 mm ✔ | 已實測；長 68，所以槽深改 4 mm。公差測試片已驗證：槽能卡住鋁管 |
| `COUPLING_L` | 66 mm | 聯軸器總長，用來確定立板 A 和 B 的間距 |

## 7. 裝配步驟

先統一兩個說法：

- **立板正面**：沒有腳板和加強筋的那一面（平的）。**背面**：有腳板和加強筋的那一面。
- **擋板內側**：有環形槽的那一面。**外側**：平的那一面。

裝好後從側面看（左邊是電機）：

```
        A                    B                                    C
        |                    |                                    |
 [ M ]==|===[ J ]======[ K ]=|==[F][D1]======= tube =======[D2]===|=[ K ]==
        |\                  /|                                    |\
========+---              ---+====================================+---=====
         foot ->        <- foot                                    foot ->
```

M 電機，J 梅花聯軸器，K KFL002，F 法蘭（法蘭盤在鋁管裏，輪轂穿過 D1 朝 B），D1 驅動側擋板，D2 從動側擋板，tube 鋁管，最下面一行是 2020 型材。A 的腳板朝右，B 的腳板朝左，C 的腳板朝右。

### 第一部分：不用 M5×16，現在就能做

**步驟 1　試裝（不塗膠）**

- 光軸能順滑穿過 D2 的中心孔；法蘭輪轂能順滑穿過 D1 的中心孔。
- 鋁管兩端能插進兩塊擋板的槽。
- M5 能穿過 Ø5.5 孔，M6 能穿過 Ø6.5 孔。穿不過就用同尺寸鑽頭手擰鉸一下。

**步驟 2　法蘭裝到 D1**

1. 法蘭盤貼在 D1 內側，輪轂從 D1 的中心大孔穿到外側。
2. 3 顆 M5×25 從內側穿進去，穿過法蘭盤上 Ø47.5 那 3 個孔，再穿過 D1。
3. 外側每顆套一片 M5 平墊片，擰一個尼龍防鬆螺母；用內六角扳手按住螺栓頭擰緊。
4. 在 3 個螺栓頭和法蘭盤之間點一點 AB 膠。這樣以後在外側擰螺母，螺栓不會跟着轉。

**步驟 3　乾裝捲筒（不塗膠，確認能裝上）**

1. 鋁管一端插進 D1 內側的槽，另一端插進 D2 內側的槽。
2. 4 根 M5×95 螺桿穿過兩塊擋板上的 4 個孔（螺桿在鋁管裏面）。
3. 每根螺桿兩端各套一片加大墊片、擰一個尼龍防鬆螺母，兩端露出的長度一樣（約 3 mm）。
4. 能裝上就擰下 D2 這一端的 4 個螺母，取下 D2。

**步驟 4　塗膠固定捲筒**

1. 鋁管兩端用砂紙打毛。
2. 兩塊擋板的槽裏塗 AB 膠，把 D2 裝回去。
3. 光軸上抹一層薄油，從 D1 外側插進法蘭孔，一直穿出 D2 的中心孔。光軸在這裏只當夾具，保證兩塊擋板同心。
4. 4 根螺桿按對角順序一點點擰緊，到擋板貼緊鋁管為止，擦掉擠出來的膠。
5. 放着固化 24 小時，然後抽出光軸。

D2 只靠 8 mm 厚的中心孔套在軸上（孔比軸大 0.2 mm），它正不正全靠鋁管端面和 4 根螺桿；歪 1° 外緣就會擺 ±1.2 mm 左右。在桌上固化看不出它歪沒歪，**更好的做法是塗膠後不在桌上固化**：光軸不抹油，直接按步驟 9、10 裝進捲線器，按步驟 10 第 3 項對正 D2，再讓膠在捲線器上原位固化 24 小時（期間不要轉捲筒）。

**步驟 5　KFL002 裝到立板 B、C（等膠乾的時候做）**

1. KFL002 的平底面貼在立板背面，中心對準立板的中心孔。
2. 2 顆 M6×25 外六角從立板正面穿入（螺絲頭下墊 M6 平墊片），穿過立板和 KFL002 的兩個耳朵孔。
3. KFL002 那一側擰 M6 螺母，塗螺紋膠擰緊。
4. B、C 兩塊做法完全一樣。

### 第二部分：M5×16 到了再做

**步驟 6　電機裝到立板 A**

1. 電機出軸的那一面貼在立板 A 正面，軸從中心孔穿到背面。
2. 轉動電機，讓 4 個螺孔對準立板上的 4 個孔，同時讓電機線朝下或朝側面。
3. 4 顆 M5×16 各套一片平墊片，從立板背面擰進電機，塗螺紋膠。

**步驟 7　聯軸器套到電機軸上**

1. 梅花聯軸器分成三件：12 mm 孔那半、梅花墊、15 mm 孔那半。
2. 12 mm 那半套到電機軸上，頂絲對準軸上的削平面，電機軸端和聯軸器端面齊平，塗螺紋膠擰緊頂絲。
3. 梅花墊和 15 mm 那半套上去，15 mm 那半的頂絲先不擰。

**步驟 8　立板裝到型材上**

1. 兩根 400 mm 型材平行擺放，中心距 80 mm；每根型材槽裏放 3 個 T 型螺母。
2. 按上面的圖擺三塊立板：A 腳板朝右，B 腳板朝左，C 腳板朝右。型材左端比 A 的正面多出約 110 mm，放電機。
3. 間距：A 正面到 B 正面 110 mm；B 正面到 C 正面 116.5 mm。
4. 每塊腳板 2 顆 M5×16，先套加大墊片、再套平墊片，擰進 T 型螺母。
5. B、C：用角尺靠住立板正面和型材，把立板立直、間距對好，然後擰緊腳板螺絲。用手推立板頂端應該推不動。A 先輕輕擰上，還要能滑動。

KFL002 的軸承是調心的，光軸不會把立板扶正，立板豎不豎直只靠腳板。所以 B、C 的腳板一定要在擰 KFL002 頂絲**之前**擰緊；反過來做，腳板位置和光軸鎖定的距離差一點，立板就會被拉歪。

**步驟 9　裝捲筒和光軸**

1. 捲筒放在 B、C 之間，D1（法蘭那頭）朝 B。
2. 光軸從 C 的右側插入，依次穿過：C 上的 KFL002 → D2 → 法蘭 → B 上的 KFL002 → 聯軸器 15 mm 那半。
3. 光軸右端比 C 上 KFL002 的內圈多出約 1 mm。這時光軸應該能在兩個 KFL002 裏輕鬆推動；推不動就是 B、C 的間距或高度不對，先回去查立板。
4. 轉動兩個 KFL002 的內圈，讓其中一顆頂絲對準削平面，擰緊。擰的時候不要推拉光軸和立板。光軸現在固定了。

**步驟 10　固定捲筒**

1. 左右推捲筒，調到：D2 外側的螺桿頭離 C 的 M6 螺絲頭約 2 mm，D1 外側的螺母離 B 的 M6 螺絲頭約 10 mm。
2. 轉動捲筒，讓法蘭輪轂上的切縫對準光軸的削平面，擰緊輪轂上的 M4 抱緊螺絲。
3. 檢查擺動：一支筆用膠帶固定在型材上，筆尖離 D2 外側面靠外緣處約 1 mm，慢慢轉捲筒，一圈下來間隙變化不超過約 0.5 mm。超了就趁膠沒乾，在間隙最小的位置把最近那根螺桿 D2 這頭的螺母擰緊約 1/8 圈，反覆調。D1 也晃的話，先查法蘭盤是否平貼 D1，或者把法蘭在軸上轉 90°/180° 再夾緊，挑擺動最小的位置。

**步驟 11　對好聯軸器**

1. 把立板 A（連電機）往右推，讓 12 mm 那半的爪插進梅花墊。用角尺把 A 立直，擰緊 A 的 2 顆腳板螺絲。
2. 沿光軸推 15 mm 那半，讓梅花墊兩邊各留約 1 mm 間隙。不要把梅花墊壓緊，否則電機會通過光軸把 B、C 頂歪。
3. 擰緊 15 mm 那半的頂絲（壓在削平面上，塗螺紋膠）。

**步驟 12　檢查**

1. 用角尺再看一遍三塊立板，都要豎直。
2. 用手轉捲筒幾整圈：要順滑、沒有異響，轉動的零件不碰任何不動的零件，重點看 C 這邊的螺桿頭和 M6 螺絲頭。
3. 用油漆筆在法蘭和軸、各頂絲、各螺母上畫一條線，以後一眼就能看出有沒有鬆。
4. Dyneema 線穿過擋板上的 Ø3 小孔打結，手轉捲筒先繞幾圈。

## 8. 使用前須知（安全）

- **在手拉測試的電流、轉速限制設好，測試用的 lisp 準備好之前，不要用原版 `vesc-code.lisp` 帶動這個捲線器**（見 `地面手拉測試_2026-11-06.md`）。 原版代碼在沒有線拉力時會以 8–20 A 的電流全力收線，空載時捲筒會飛車（6S 下收線速度約 5 m/s，12S 下約 10 m/s）。
- 首次通電只用 VESC Tool 手動給小電流（≤ 2 A）低速轉動，檢查同心度、異響，以及頂絲有沒有鬆動。
- 轉子殼會外露旋轉。測試時要保持手和線遠離電機，以後再加轉子防護罩。
- 新電機必須在 VESC Tool 裏重新做 FOC 參數檢測。

## 9. 後續（不在本文範圍）

1. 地面手拉測試：捲線器放地上、人手拉線，標定「電流 → 線拉力」，步驟見 `地面手拉測試_2026-11-06.md`。原來的桌邊臺架暫不搭建，設計保留在 `機械設計/臺架/文檔/臺架設計文檔_2026-10-30.md`。
2. VESC 配置（`si_gear_ratio = 1`，`si_wheel_diameter` 按實測有效捲徑）和 lisp 閾值修改（配合 50 m 線）。
3. 排線舵機臂和導向環。
4. 野外地錨接口。
