198010ggh-stack/awe_ground/機械設計/臺架/文檔/臺架設計文檔_2026-10-30.md

# 捲線器臺架測試架：滑輪座裝在捲線器上 + 水桶

日期：2026-10-30（v2：2026-11-01）

> **狀態（2026-11-06）**：老師要求改成把捲線器放在地上、用手拉線測試，**臺架暫不搭建**，本文保留作記錄。第 9 節的六維力傳感器和上、下吊板可以直接用在手拉測試上：串在線和手柄之間測線拉力。

範圍：在桌上測試捲線器用的架子、掛重物的方法和標定步驟。臺架專用 lisp、VESC 配置不在本文範圍內，另寫。捲線器本體見 `機械設計/捲線器/文檔/捲線器設計文檔_2026-10-20.md`。

## 0. v2 改了什麼

v1 的滑輪放在離捲筒 250 mm 的桌邊，所以要用兩根 2020 橫樑和四個角碼把滑輪座接回捲線器，F 夾還要從桌外伸進來 60 mm 夾橫樑；重物用槓鈴片和 M12 掛桿。要買的東西有 13 項。

v2 把滑輪座直接頂在捲線器近桌邊那根型材的外側面上，滑輪架在桌邊上方：

| | v1 | v2 |
|---|---|---|
| 滑輪座固定 | 2 根橫樑 + 4 個角碼 + 2 個 F 夾 | 2 顆 M5 擰進捲線器型材的側槽 |
| 擋線銷 | M4 × 45 螺栓 | 打印的 Ø5 擋線梁 |
| 重物 | 槓鈴片 + M12 掛桿 + D 形扣 | 水桶裝水，行李秤稱重 |
| 要買的 | 13 項 | 608ZZ × 2、M8 螺栓一套；建議加一個防打火開關 |
| 行程 | 約 0.4–0.5 m | 約 0.3 m |
| 滑輪 | Ø52 V 槽打印件 | 不變 |

## 1. 目標與約束

| 項目 | 取值 |
|---|---|
| 用途 | ① 標定「電流 → 線拉力」；② 讓臺架 lisp 帶載低速收放線 |
| 拉力範圍 | 0 – 約 100 N（10 kg 水；原版 lisp 最大 23 A ≈ 95 N） |
| 行程 | 約 0.3 m（桌高 750 mm、10 L 水桶時） |
| 速度 | 低速，≤ 0.2 m/s（捲筒約 42 rpm） |
| 安裝 | 結實的桌子邊；不夾、不打孔 |
| 加工條件 | 3D 打印（PLA）+ 網購標準件；不需要鑽孔 |
| 已有 | 手提行李秤（稱水桶，以及方法 1 的讀數） |

## 2. 佈局

順着光軸看（桌面以下的高度不按比例）：

```
              捲筒（軸心離桌邊 85、離桌面 105）
                .-"""-.
               (   +   )
                '-._.-'
                   \______________ 線，離桌面 59.5
  [R2]     [R1][滑輪座](◎)         滑輪軸心：離 R1 外側面 30、離桌面 39
 ═════════════════ 桌面 ═══╗ │     線在桌邊外約 16 mm 處往下
                           ║ │
                           ║ [水桶]
                         地面鋪墊子
```

- 捲線器的兩根型材和桌邊平行。近桌邊的叫 R1，遠的叫 R2。**R1 外側面離桌邊 35 mm**，也就是捲筒軸心離桌邊 85 mm。
- 滑輪座的立邊貼住 R1 外側面，2 顆 M5 擰進 R1 側槽裏的錘頭 T 型螺母；兩側腳板壓在桌面上，**前沿和桌邊齊平**。滑輪座的前沿就是擺放時的基準。
- **線從捲筒下方出來**，水平走 80 mm 到滑輪。線高 = 型材 20 + 軸高 85 − 捲筒半徑 45.5 = **59.5 mm**（以桌面為 0）。滑輪槽頂接住這根線，線轉 90° 在桌邊外約 16 mm 處往下，吊一桶水。
- 滑輪座可以沿 R1 的側槽滑動。裝好後讓滑輪槽對準線在捲筒上實際纏繞的位置；臺架上線只繞幾圈，這個位置基本不動。
- 測試只用一段約 **1.5 m** 的 Dyneema Ø1 線，不用 50 m 線：出事時捲筒能收回的線很少。

### 2.1 對桌子的要求

- **桌邊平直**：不能有凸出的邊條，線在桌邊外只有約 16 mm。
- **掛水桶的地方下面是空的**：水桶直徑約 26 cm，有一大半在桌面下方，那裏不能有桌腿、抽屜或橫檔。
- **桌子夠穩**：普通書桌、實驗臺都行；很輕的摺疊桌不行。
- **桌子越高行程越長**：桌高 750 mm、10 L 水桶時行程約 0.3 m。

## 3. 零件設計

### 3.1 滑輪（打印 1 個，和 v1 相同）

| 項目 | 取值 |
|---|---|
| 外徑 / 寬 | Ø52 / 15 |
| 槽 | 90° V 槽，深 6，槽底 Ø40；兩側輪緣各剩 1.5 mm 平面 |
| 軸承孔 | 兩側各一個 Ø22.0 × 7 深，各壓一個 608ZZ |
| 中間擋肩 | 兩個軸承孔之間留 1 mm 厚的擋肩，孔 Ø19，只頂軸承外圈 |
| 打印 | 軸線朝上平放；90° 槽的斜面正好 45°，不用支撐 |

- 線在 V 槽底，中心離軸約 20.7 mm。
- 軸承孔 Ø22.0 按公差片的經驗應該是緊配（Ø15.2 孔能順滑通過 Ø15 軸，說明孔基本不縮）。壓不進就用砂紙或鉸刀修，太鬆就點一點 AB 膠。

### 3.2 滑輪座 v2（打印 1 個）

坐標：x 從 R1 外側面朝桌外（桌邊在 x = 35），y 沿桌邊，z 從桌面往上。打印時底面朝下，不用支撐。

| 項目 | 取值 |
|---|---|
| 立邊 | x 0 … 8，y ±50，高 20（和型材一樣高）；貼住 R1 外側面 |
| 立邊螺絲孔 | 2 個 Ø5.5，水平，在 y = ±40、z = 10（R1 側槽中心） |
| 腳板 | x 8 … 35，y ±16.3 … ±31，厚 8；前沿和桌邊齊平 |
| 側板 | 厚 8，兩片之間淨距 **16.6**（滑輪 15 + 兩邊凸台各 0.8）；x 0 … 58，z 0 … 69 |
| 側板之間 | 底下是空的，滑輪從下面裝進去 |
| 滑輪軸孔 | Ø8.4，中心 **x = 30、z = 39** |
| 凸台 | 兩片側板內側，圍着軸孔，Ø11 × **0.8** 高，只頂軸承內圈 |
| 擋線梁 | 打印的 Ø5 橫梁，連着兩片側板，在滑輪軸斜上方、朝桌外 45°，離軸心 29.3（x = 50.7、z = 59.7） |

- **軸心高度**：線心離軸 20.7，捲筒上的線高 59.5，所以軸心 z = 39（線在滑輪上高 59.7，差 0.2 mm，可忽略）。
- **滑輪位置**：滑輪最靠型材的一點在 x = 4，最低點離桌面 13 mm，下面是空的；滑輪離立邊上角最近處約 3 mm。
- **凸台高 0.8 而不是更高**：滑輪側面和側板之間的縫只有 0.8 mm，比線徑 1 mm 小。萬一線跳出槽，也卡不進側縫。
- **擋線梁**：表面離輪緣只有 0.8 mm，線擠不出去。位置在線包住的那 90° 弧中間，不擋進線也不擋出線。打印時是一段 16.6 mm 長的橋接，沒問題。
- **腳板只到 y ±31**：M5 頭下的 Ø15 加大墊片在 y = 40 ± 7.5，腳板要讓開；內六角扳手也從這裏水平伸進去。
- **立邊螺絲**：2 顆 M5 × 16，和捲線器腳板一樣疊 M5 加大墊片 + M5 平墊片（疊起來約 10.2 mm，螺絲尖不會頂到型材槽底），擰進 R1 側槽的錘頭 T 型螺母。錘頭 T 型螺母能從槽口直接放進去再轉 90°，捲線器不用拆。

### 3.3 掛水桶

```
線末端單套結（布林結）→ 水桶提手
```

- 約 10 L 的水桶，加減水調重量，每次用行李秤**連桶帶水一起稱**。比槓鈴片一檔 1.25 kg 更細。
- 線直接打結拴在提手中間。提手上方的線上穿一小塊海綿，水桶被拉到頂時先撞海綿。
- 地上鋪舊靠墊或紙箱接住水桶。
- 想要更長的行程，可以把幾瓶水裝在布袋裏代替水桶：布袋比水桶矮。

### 3.4 受力校核

- **線的水平拉力**：捲筒和滑輪都裝在捲線器上，水平拉力 T 由「捲筒軸 → 立板 → R1 → 滑輪座」自己抵消，不傳給桌子，所以不需要夾。
- **會不會被掀翻**：桌子只承受吊着的重量。10 kg（98 N）在桌邊外約 16 mm 往下，對桌邊的掀翻力矩約 1.5 N·m。捲線器約 4.4 kg（估算），重心在桌邊內約 85 mm，回正力矩約 3.7 N·m，**不夾也翻不了**，餘量約 2.4 倍。保險起見，在電機下面的型材上壓兩本厚書，防止碰到時滑動。
- **滑輪座受力**：滑輪上的合力約 1.41 T，斜向桌內下方，作用線經過滑輪軸，在 x ≈ −9 處穿過桌面，也就是在 R1 底下。滑輪座被壓向 R1 和桌面，2 顆 M5 只負責定位，基本不受力。
- **M8 軸在 PLA 孔裏**：100 N 時合力 141 N，兩片側板分擔，孔壁擠壓應力約 1 MPa，遠小於 PLA 強度。
- **立板**：線拉力水平、垂直於光軸，是捲線器設計時校核過的方向（沿板面受力，見捲線器設計文檔 4.1）。

## 4. 物料清單

**打印件**（PLA，參數和捲線器打印件一樣：8 圈壁、60% 螺旋體填充、頂層底層各 6 層）

| # | 名稱 | 數量 | 用料 |
|---|---|---|---|
| P1 | 滑輪（和 v1 相同，打過的直接用） | 1 | 約 25 g |
| P2 | 滑輪座 v2 | 1 | 約 90 g |

**要買的**

| # | 名稱 | 規格 | 數量 |
|---|---|---|---|
| 1 | 深溝球軸承 | 608ZZ（8 × 22 × 7） | 2 |
| 2 | 滑輪軸 | M8 × 50 外六角螺栓 + M8 尼龍防鬆螺母 + M8 平墊片 × 2 | 1 套 |
| 3 | 防打火開關（建議，當急停） | XT60，≥ 60 A | 1 |

**已有的 / 家裏有的**

| 名稱 | 說明 |
|---|---|
| M5 × 16 內六角 + M5 加大墊片 + M5 平墊片 + 20 系列 M5 錘頭 T 型螺母，各 2 | 用捲線器剩下的；沒有就買 |
| Dyneema 線 Ø1.0 約 1.5 m | 從現有的線上剪 |
| 手提行李秤 | 已有 |
| 約 10 L 的水桶 | 帶提手 |
| 一小塊海綿、舊靠墊或紙箱、兩本厚書 | 緩衝、接水桶、壓重 |

## 5. 安裝步驟

1. 兩個 608ZZ 從兩側壓進滑輪，壓到頂住中間擋肩。用手轉，要順滑。
2. 滑輪從滑輪座底下塞進兩片側板之間。M8 × 50 從一側穿過側板、兩個軸承、另一側板，兩頭各墊一片墊片，擰尼龍螺母，擰到滑輪沒有軸向晃動但仍能自由轉。
3. 轉一圈滑輪，確認輪緣不碰擋線梁和立邊。
4. 在捲線器 R1（近桌邊那根型材）外側面的槽裏放 2 個錘頭 T 型螺母，從槽口放進去再轉 90°。位置大約在捲筒中間兩側各 40 mm。
5. 捲線器放到桌上，型材和桌邊平行，R1 外側面離桌邊 35 mm。
6. 1.5 m 的線一頭穿過擋板上的 Ø3 小孔打結，在捲筒上**從下方**往桌邊方向繞 2–3 圈。
7. 滑輪座立邊貼住 R1 外側面，腳板壓在桌面上，前沿和桌邊齊平。沿型材推動，讓滑輪槽對準線在捲筒上的位置，然後擰上 2 顆 M5 × 16（疊加大墊片 + 平墊片）。
8. 線經滑輪槽頂，從擋線梁和滑輪之間轉向下；末端穿一小塊海綿，打單套結拴在水桶提手中間。地上鋪墊子。
9. 電機下面的型材上壓兩本厚書（可選）。
10. 電池線上串防打火開關，放在伸手就能按到的地方。

## 6. 標定方法

**前提**：捲線器已經按設計文檔第 8 節做過首次通電（FOC 參數檢測、≤ 2 A 空轉檢查）。兩種方法都要求電機在**零轉速附近**能穩定出力，要靠霍爾傳感器或 HFI。電機上那幾根細線如果是霍爾線，首次通電時就接上。

**方向**：在 VESC Tool 裏給正電流，水桶應該被提起（收線）。反了就在 VESC Tool 裏把電機方向反過來，不要改接線。

**記錄的數**：捲筒上只有幾圈線時，線心半徑 r = 45.5 mm。

### 6.1 方法 1：靜態標定（捲筒不轉）

1. 水桶裝滿約 10 kg 水，放在地上。吊秤上端掛線末端的繩圈，下端鉤住水桶提手。調線長，讓線剛好拉直、水桶不離地。
2. VESC Tool 裏依次給 2、4、6 … 20 A，每檔保持不超過 5 秒，讀吊秤。20 A 約 84 N，小於 98 N，水桶不會被提起；如果還沒到 20 A 水桶就離地，就停在前一檔。
3. 每兩檔之間停一下，讓電機降溫。
4. 吊秤讀數（kg）× 9.81 = 線拉力（N）。

### 6.2 方法 2：水桶升降

1. 往水桶裏加水，用吊秤連桶一起稱到 2.5、5、7.5、10 kg，記下總質量 m。
2. VESC Tool 裏從 0 慢慢加電流，記下水桶**剛開始上升**的電流 I_up。
3. 再慢慢減電流，記下水桶**剛開始下降**的電流 I_down。
4. 這個重量對應：拉力 T = m × 9.81；電流 I = (I_up + I_down) / 2；摩擦相當的電流 = (I_up − I_down) / 2。
5. 四個重量各做一次。
6. 臺架 lisp 寫好後也在這個模式下試收放線。

### 6.3 結果和通過標準

- 把各點畫成「拉力 T – 電流 I」，擬合一條直線 T = k × I + b。
  - k 是線拉力係數（N/A）。裸管上預計 **3.6–4.2 N/A**。
    - 4.2 是按 Kt = 9.55 / Kv = 0.19 N·m/A 算的，對應方波驅動下的直流電流。
    - VESC 在 FOC 下顯示的「電機電流」是相電流峰值。按這個定義，Kt 要再乘 0.87，約 0.165 N·m/A，k 約 3.6。
    - 電機標的 Kv 本身也常有 ±10% 誤差。
  - 做完 VESC 電機參數檢測後，可以用測出的磁鏈 λ 先算一個更準的預計值：Kt = 1.5 × 極對數 × λ。
  - Kt = k × r 是電機轉矩常數。捲徑變了 k 會跟着變，Kt 不變，所以以後換算用 Kt。
  - 只要先知道大概的拉力，方法 2 用 5 kg 測一個點就夠了；四檔全測是為了看直線度和摩擦。
- **通過**：各點基本在一條直線上；方法 1 和方法 2 得到的 k 相差不超過 10%。
- 每做完一檔重量，看一眼立板根部、滑輪座和螺栓孔周圍有沒有發白或裂紋。

## 7. 安全

- **原版 `vesc-code.lisp` 和 `vesc-code_test.lisp` 不要刷進 VESC**。兩者在沒有拉力時都會一直收線。
- 防打火開關當急停，放在手邊；不買的話，至少把 VESC 裏的電流上限設低，電池插頭放在伸手能拔到的地方。電機電流上限先設 **10 A**，標定時再按需要調高，最高不超過 25 A。
- 人不要站在水桶下方，也不要靠近電機和聯軸器（轉子和聯軸器都還沒有防護罩）。
- 加減水時先斷電。
- 水桶晃動時會蹭到桌邊，升降要慢。
- 水桶被拉到頂時會先撞海綿；但主要還是靠低電流上限和手邊的急停，以後由臺架 lisp 按線長限位。

## 8. 交付物

- `機械設計/臺架/腳本/build_rig.py`：用 SolidWorks 腳本建滑輪和滑輪座 v2（沿用捲線器 `build_parts.py` 的寫法）。
- `機械設計/臺架/滑輪.SLDPRT`、`機械設計/臺架/滑輪座.SLDPRT`（v2）。
- `機械設計/臺架/打印件/滑輪_打1個.STL`、`機械設計/臺架/打印件/滑輪座_打1個.STL`（高精度導出，每個圓 180 段）。
- `機械設計/臺架/打印件/上吊板_打1個.STL`、`下吊板_打1個.STL`（2026-11-05，掛六維力傳感器用，見第 9.3 節；SLDPRT 待 SolidWorks 生成）。
- `機械設計/臺架/文檔/臺架_網頁3D模型.html`：可旋轉的 3D 模型，能調電流模擬水桶升降；2026-11-05 加了串在線上的六維力傳感器和模擬讀數（見第 9 節）。
- `機械設計/臺架/文檔/臺架動圖_整體.gif`、`臺架動圖_滑輪特寫.gif`：給 PPT 用的循環動圖。

已核對（2026-11-01）：

| 零件 | 外形 | 體積 | 打印擺放 |
|---|---|---|---|
| 滑輪 | Ø52 × 15 | 20.8 cm³（和按截面算的一致） | STL 已平放，哪面朝下都行 |
| 滑輪座 v2 | 58 × 100 × 69 | 76.6 cm³（和手算一致），單一實體 | STL 已是底面朝下，直接打，不加支撐 |

- 預覽圖：`機械設計/臺架/文檔/滑輪座預覽.png`（滑輪裝在滑輪座上，橙線是線的走向）。
- 在 STL 上抽樣檢查：滑輪轉動的包絡（半徑 26.3、兩側面之間）、進線和出線的通道裏都沒有滑輪座的材料；離輪緣最近的是擋線梁，0.8 mm。

## 9. 加六維力傳感器（2026-11-05）

傳感器用法、接線、協議見 `傳感器/HKVL-56六維力/使用筆記.md`；3D 模型已加進 `臺架_網頁3D模型.html`（「傳感器特寫」視圖）。

### 9.1 放在哪

**串在線末端和水桶之間**，工具端朝上接線，固定端朝下掛水桶：

```
線（單套結）→ 上吊板吊耳 → HKVL-56C → 下吊板吊耳 → S 鉤 → 水桶提手
```

- 傳感器只受拉力，Fz 就是線拉力，力矩幾乎為 0。10 kg 時負載率 (98/300)² ≈ 0.11。
- **不裝在滑輪座下面**，有兩個原因：
  - 滑輪座壓在桌面上、又頂在型材上，力會從這兩條路繞過傳感器，讀數偏小。要測準，被測的一側除了傳感器不能碰別的東西。
  - 線高 59.5 mm 由捲筒定死，滑輪最低點離桌面只有 13 mm，放不下 22.5 mm 厚的傳感器。把滑輪往外挪又會多出幾 N·m 的力矩。
- 滑輪座、捲線器都不用改。
- 出線口朝 +x（沿桌邊），所以 Fx 沿桌邊、Fy 朝桌外、Fz 朝上。傳感器的線留約 0.4 m 鬆弛的弧，卡在桌子前沿下面，再上到桌面接端子和 485 模塊。

### 9.2 尺寸和行程

| 項目 | 取值 |
|---|---|
| 上吊耳孔（線結）到水桶提手頂 | 88 mm（上吊板 6 + 傳感器 22.5 + 下吊板 8 + 兩個吊耳 + S 鉤） |
| 線末端最高 | 桌面下 40 mm：上吊板上方的海綿先碰到滑輪座側板底 |
| 到頂時上吊板離桌板底面 | 約 26 mm。傳感器半徑 28，比線離桌邊的 16 mm 大，**傳感器始終要在桌板下面**，所以不能去掉海綿 |
| 行程（桌高 750，10 L 水桶） | 約 220 mm（不加傳感器約 320） |

### 9.3 吊板（打印 2 個，PLA，盤面朝下打印）

| | 上吊板（工具端） | 下吊板（固定端） |
|---|---|---|
| 圓盤 | Ø56 × 6 | Ø56 × 8 |
| 和傳感器連接 | 6 × Ø4.5 通孔，M4 × 10 擰進傳感器頂面的 M4 孔 | 頂面 6 個 M3 熱熔銅螺母（M3 × 5.7），接傳感器底面伸出的 M3 內埋螺栓 |
| 吊耳 | 寬 20、厚 8，Ø6 孔，孔心離盤面 11，頂部 R10 | 同左（使用時朝下） |
| 銷孔讓位 | 2 × Ø4.6 通孔，在 Ø48 圓上 150°、270° | 2 × Ø4.6 深 6，同角度 |
| 外形 / 體積 | Ø56 × 27 / 16.8 cm³（約 21 g） | Ø56 × 29 / 21.8 cm³（約 27 g） |
| 打印文件 | `打印件/上吊板_打1個.STL` | `打印件/下吊板_打1個.STL` |

- **孔位還沒確認**：按 Ø48 圓周 6 等分估的（0°、60°…，銷孔在 150°、270°）。打印前用卡尺量傳感器，或者跟賣家要 STEP 模型。兩個銷孔只是讓位，傳感器上沒裝銷子就用不上；實際銷孔如果在 30°/150°/270° 裏另外兩個位置，把吊板轉 120° 裝就行。
- 打印擺放：STL 已經是盤面朝下、吊耳朝上，直接打，不加支撐。下吊板的熱熔銅螺母從貼傳感器的那面（打印時的底面）壓進去。
- **SLDPRT 還沒生成**：2026-11-05 建模時，電腦上有一個 11/1 啟動、沒有窗口的 SLDWORKS.exe 擋着，腳本連不上 SolidWorks。STL 是按 `build_rig.py` 裏同一組參數，用 manifold3d 直接生成的（每個圓 180 段，體積和手算差 0.01%，9 個通孔/1 個通孔數對得上）。把那個後臺 SolidWorks 關掉以後，運行 `python 機械設計/臺架/腳本/build_rig.py hanger_top hanger_bottom` 會生成 `上吊板.SLDPRT`、`下吊板.SLDPRT`，並用 SolidWorks 重新導出 STL 覆蓋這兩個。
- M4 孔下面就是 M3 內埋螺栓頭，M4 螺絲擰入不要超過約 4 mm（M4 × 10 配 6 mm 盤正好）。
- 強度：吊耳淨截面約 112 mm²，按 PLA 層間強度 15 MPa 算能拉 1600 N 以上，是 300 N 量程的 5 倍多。

### 9.4 裝配順序

1. 下吊板壓好 6 個熱熔銅螺母。
2. 傳感器固定端（底面）對準下吊板。用 2.5 mm 內六角扳手從頂面的 M4 孔伸進去，按對角順序擰緊 6 顆 M3 內埋螺栓。
3. 上吊板用 6 顆 M4 × 10 擰到頂面。順序不能反，上吊板會擋住 M3 螺栓。
4. 線打單套結拴在上吊耳孔上，海綿套在結上方；S 鉤一頭穿下吊耳孔，一頭掛水桶提手。
5. 傳感器線留約 0.4 m 鬆弛的弧，卡在桌子前沿下面，確認水桶上下走完整個行程都扯不到線、線也碰不到水桶。

### 9.5 用傳感器標定（方法 3）

- 去皮：先不掛水桶，讓傳感器只吊着下吊板和 S 鉤時去皮。之後的 Fz 就是水桶重量或線拉力。
- **一桶水測整條線**：水桶放在地上，電流從 0 慢慢加到水桶快離地，再慢慢減回 0，一路記錄 (I, Fz)（`hkvl56.py --csv`）。上升段和下降段取平均就是 T = k·I + b，不用換四次水桶。前提和方法 1 一樣：電機要能在零轉速附近穩定出力。
- 水桶升降時，Fz 和 k·I 的差就是摩擦加慣性，可以直接看到。
