198010ggh-stack/awe_ground/機械設計/捲線器/文檔/手拉測試動圖_放線.gif

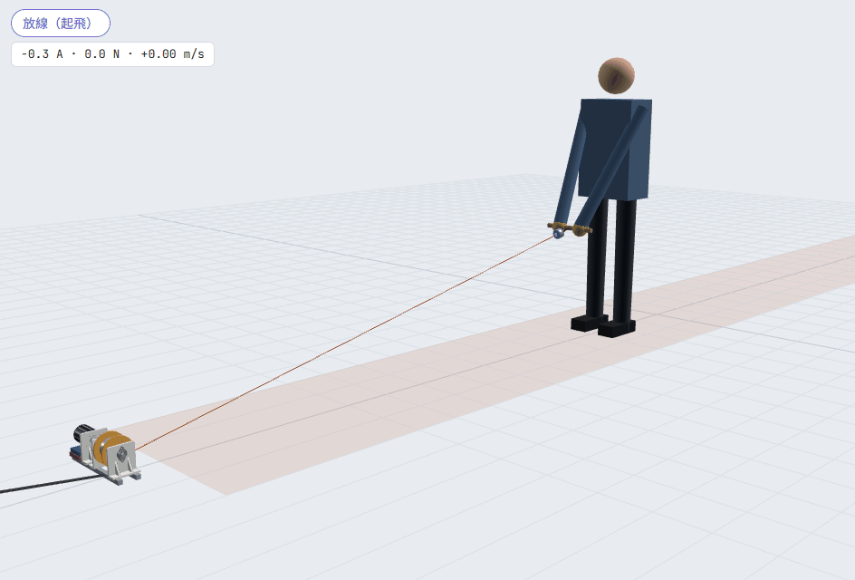
機械設計/捲線器/文檔/手拉測試動圖_放線.gif
