198010ggh-stack/awe_ground/機械設計/臺架/文檔/滑輪座預覽.png

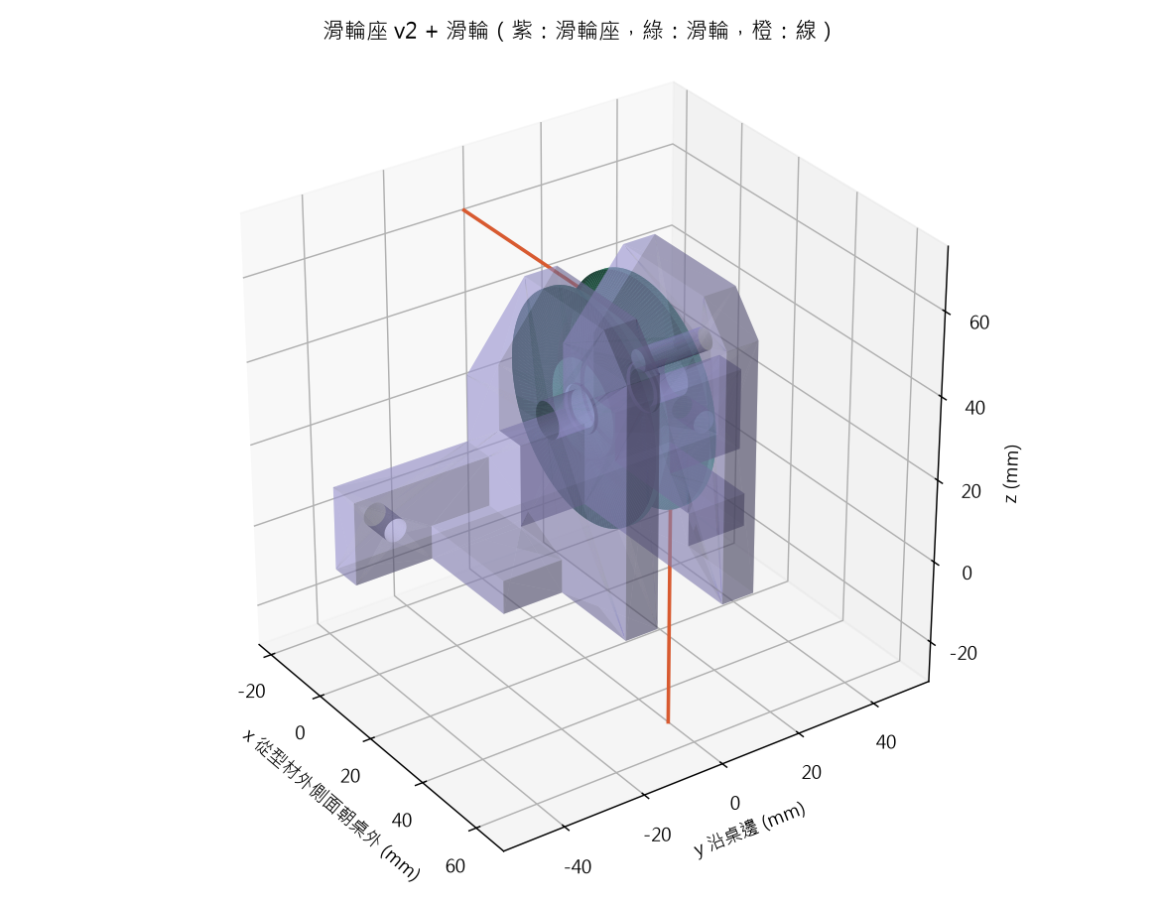
機械設計/臺架/文檔/滑輪座預覽.png
