198010ggh-stack/awe_ground/機械設計/臺架/文檔/臺架動圖_滑輪特寫.gif

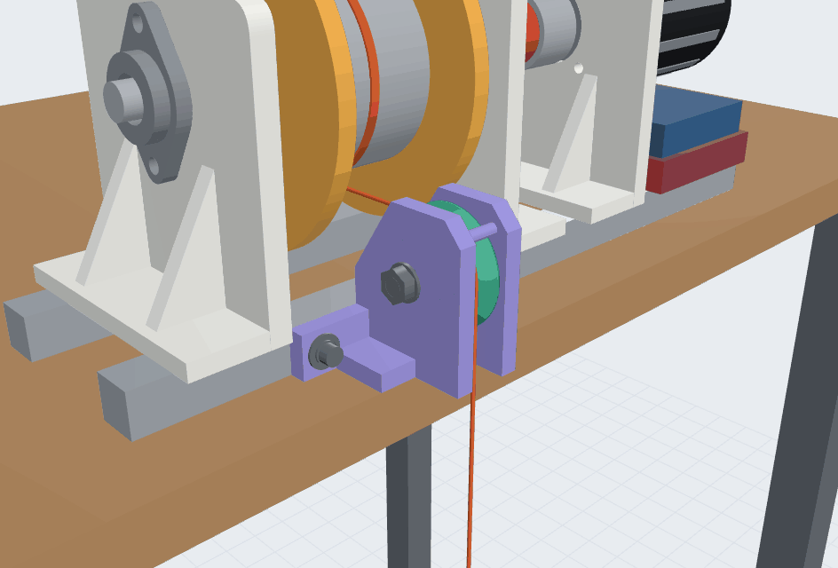
機械設計/臺架/文檔/臺架動圖_滑輪特寫.gif
