198010ggh-stack/awe_ground/機械設計/捲線器/外購件示意/KFL002.SLDPRT

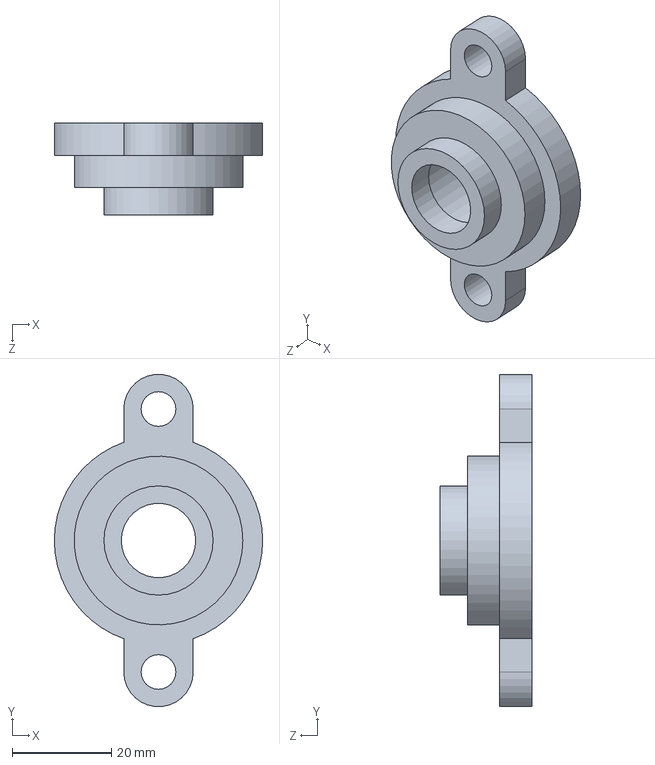
[picture p5: CAD file, 2026-10-31]
機械設計/捲線器/外購件示意/KFL002.SLDPRT
42.0 x 66.9 x 18.5 mm
