198010ggh-stack/awe_ground/機械設計/捲線器/打印件/立板BC_軸承座_打2塊.STL

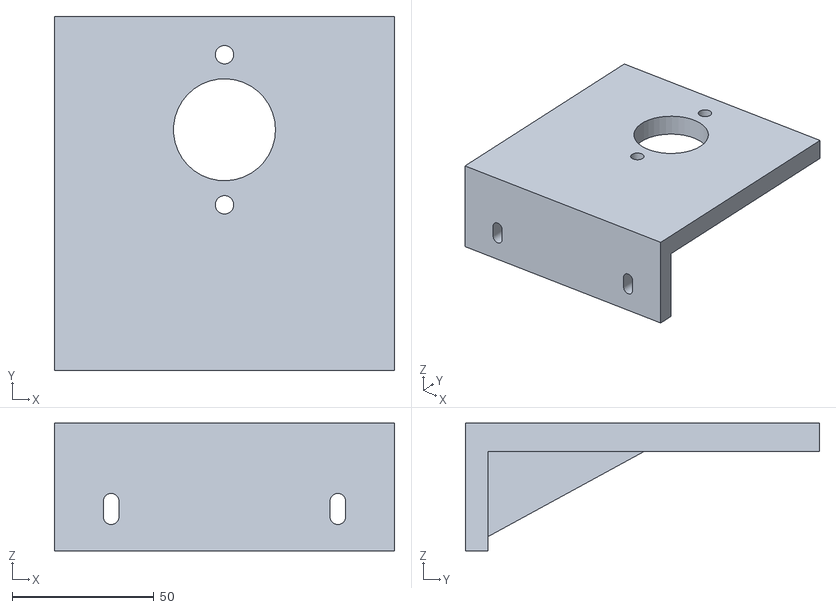
[picture p6: CAD file, 2026-10-31]
機械設計/捲線器/打印件/立板BC_軸承座_打2塊.STL
120.0 x 125.0 x 45.0
