198010ggh-stack/awe_ground/機械設計/捲線器/擋板_驅動側.SLDPRT

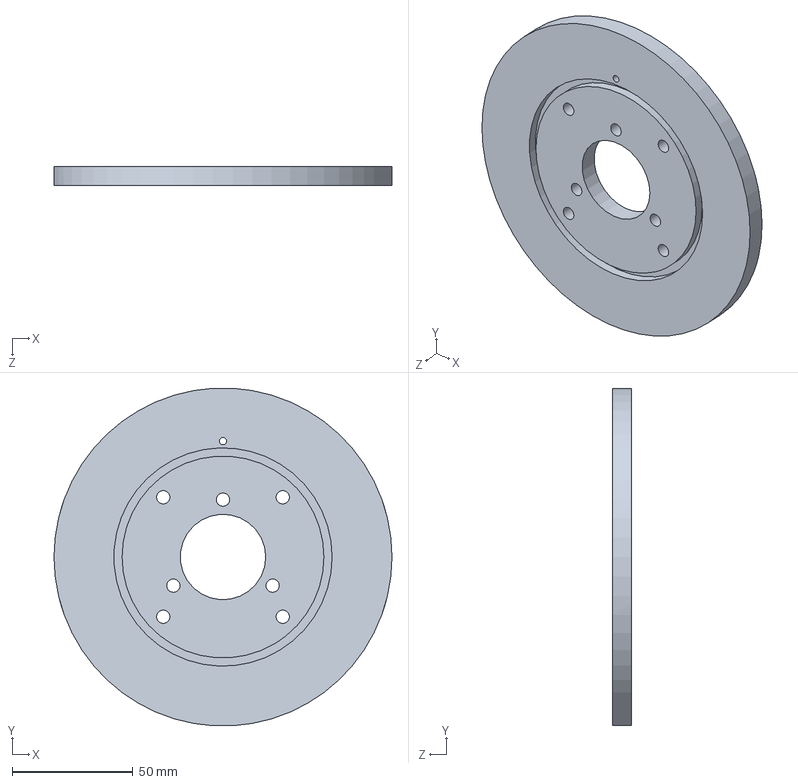
[picture p7: CAD file, 2026-10-31]
機械設計/捲線器/擋板_驅動側.SLDPRT
140.0 x 139.8 x 8.00 mm
