198010ggh-stack/awe_ground/機械設計/臺架/滑輪座.SLDPRT

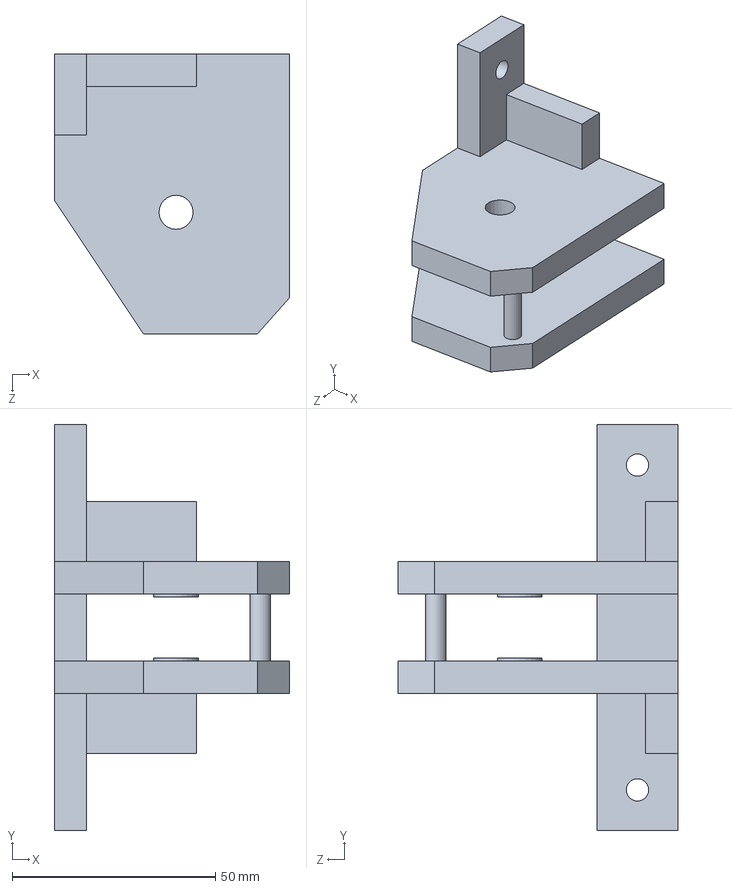
[picture p9: CAD file, 2026-11-02]
機械設計/臺架/滑輪座.SLDPRT
58.0 x 100.0 x 69.0 mm
