198010ggh-stack/awe_ground/機械設計/捲線器/外購件示意/M5加大墊片.SLDPRT

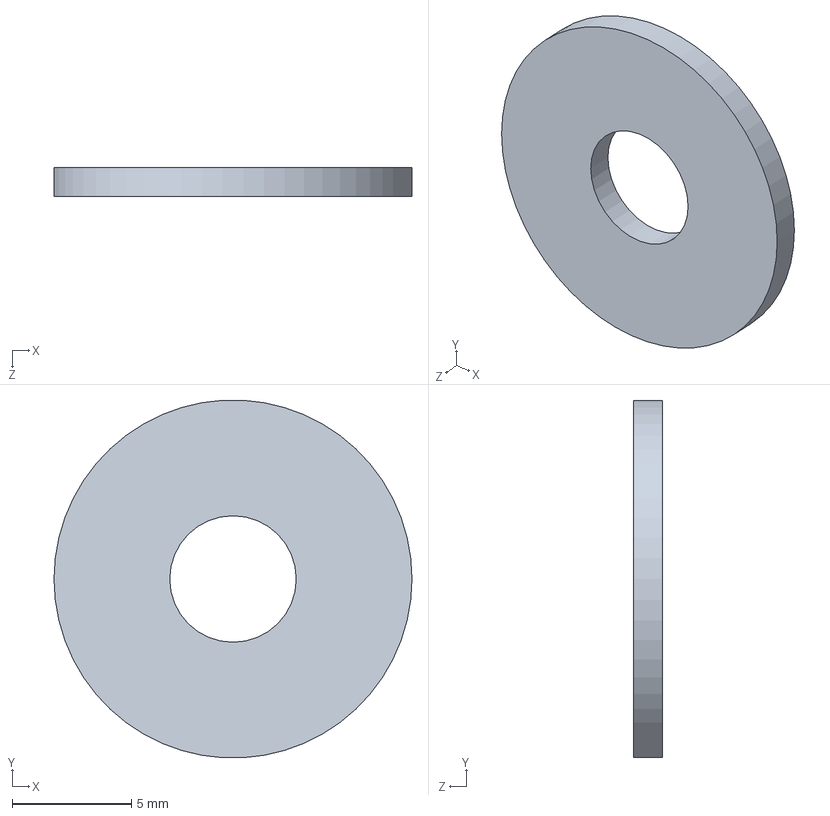
[picture p10: CAD file, 2026-10-31]
機械設計/捲線器/外購件示意/M5加大墊片.SLDPRT
15.0 x 15.0 x 1.20 mm
