198010ggh-stack/awe_ground/機械設計/捲線器/打印件/擋板_從動側_打1塊.STL

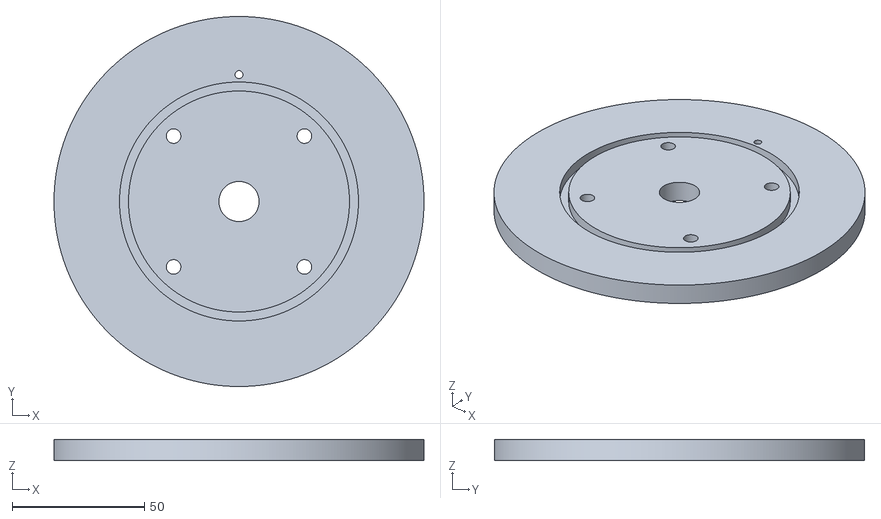
[picture p11: CAD file, 2026-10-31]
機械設計/捲線器/打印件/擋板_從動側_打1塊.STL
140.0 x 140.0 x 8.00
