198010ggh-stack/awe_ground/機械設計/臺架/打印件/上吊板_打1個.STL

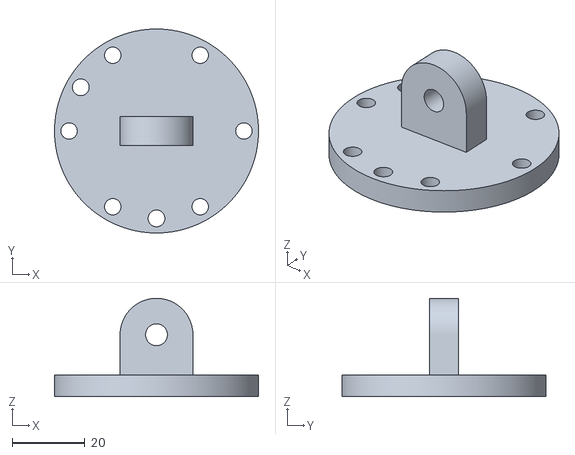
[picture p12: CAD file, 2026-11-07]
機械設計/臺架/打印件/上吊板_打1個.STL
56.0 x 56.0 x 27.0
