198010ggh-stack/awe_ground/機械設計/臺架/滑輪.SLDPRT

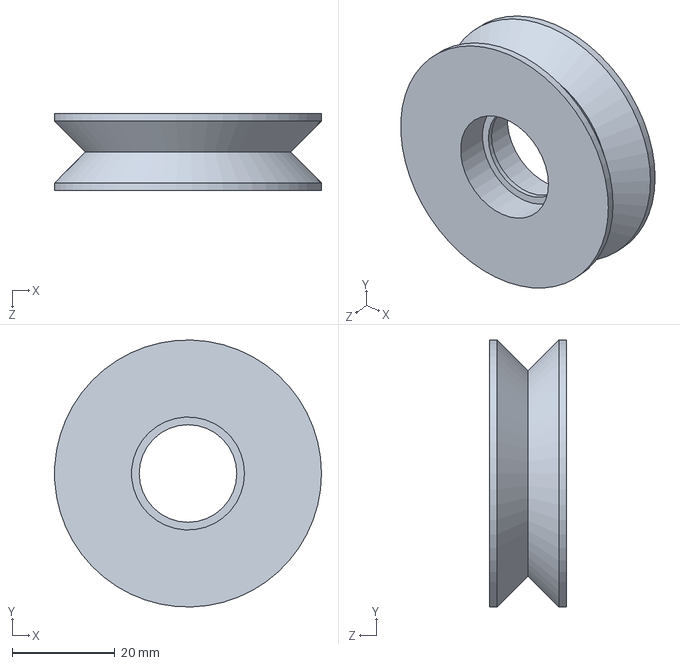
[picture p13: CAD file, 2026-10-31]
機械設計/臺架/滑輪.SLDPRT
52.0 x 52.0 x 15.0 mm
