198010ggh-stack/awe_ground/機械設計/捲線器/外購件示意/線_Dyneema_50m捲繞.SLDPRT

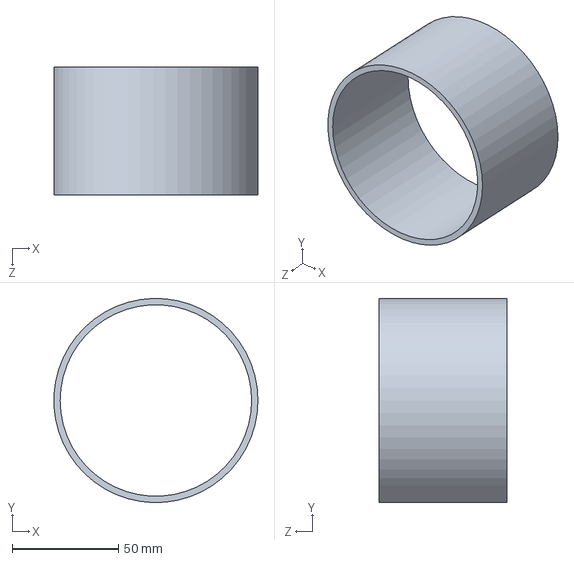
[picture p14: CAD file, 2026-10-31]
機械設計/捲線器/外購件示意/線_Dyneema_50m捲繞.SLDPRT
95.9 x 96.0 x 60.0 mm
