198010ggh-stack/awe_ground/機械設計/捲線器/外購件示意/M5尼龍防鬆螺母.SLDPRT

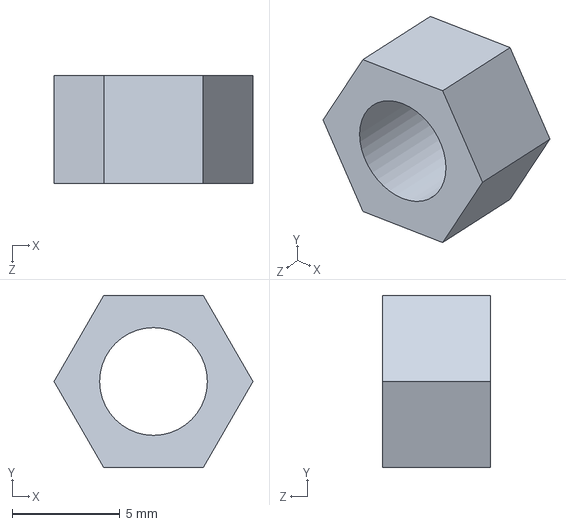
[picture p15: CAD file, 2026-10-31]
機械設計/捲線器/外購件示意/M5尼龍防鬆螺母.SLDPRT
9.24 x 8.00 x 5.00 mm
