198010ggh-stack/awe_ground/機械設計/捲線器/打印件/打印公差測試片.stl

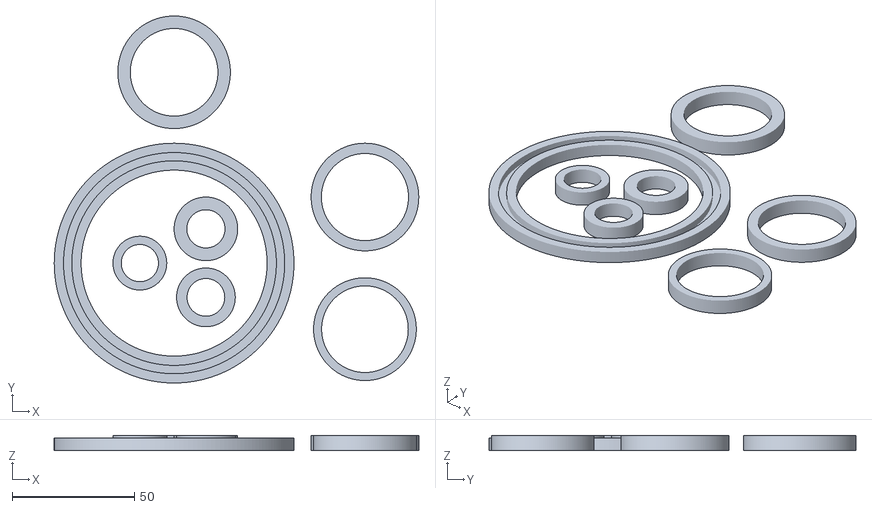
[picture p16: CAD file, 2026-10-31]
機械設計/捲線器/打印件/打印公差測試片.stl
149.0 x 150.0 x 6.00
