198010ggh-stack/awe_ground/機械設計/捲線器/捲線器_總裝.STEP

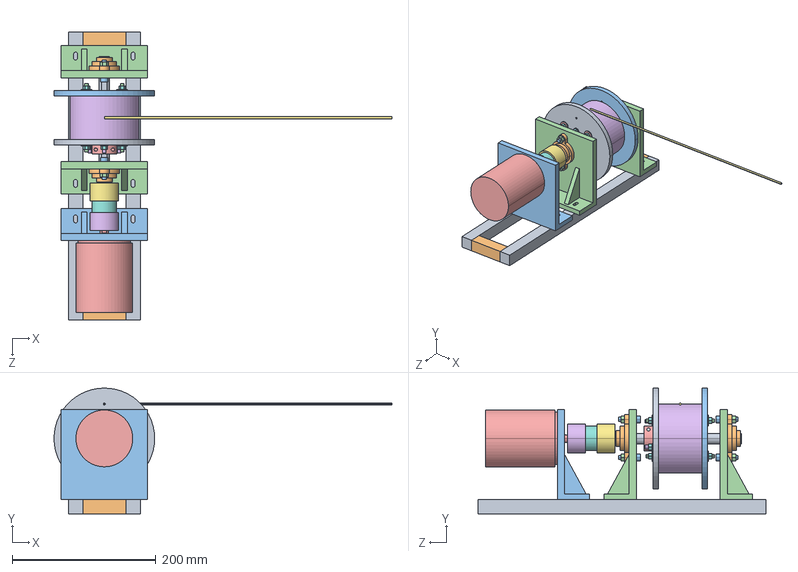
[picture p17: CAD file, 2026-10-31]
機械設計/捲線器/捲線器_總裝.STEP
470.0 x 175.0 x 400.0 mm
2020型材x400_x2
2020型材x60_橫樑 x 2
立板A_電機座
立板BC_軸承座 x 2
電機_80100_Kv50
聯軸器_爪
聯軸器_梅花墊
捲筒軸_D15x200
KFL002 x 2
M6內六角螺絲x25 x 4
M6螺母 x 4
抱緊式法蘭聯軸器_D15
M5內六角螺絲x25 x 3
M5平墊片 x 3
M5尼龍防鬆螺母 x 11
擋板_驅動側
捲筒芯_6061鋁管_D90x3x68
擋板_從動側
M5拉桿x4_L95
M5加大墊片 x 8
線_Dyneema_50m捲繞
線_出線段
