198010ggh-stack/awe_ground/機械設計/捲線器/外購件示意/抱緊式法蘭聯軸器_D15.SLDPRT

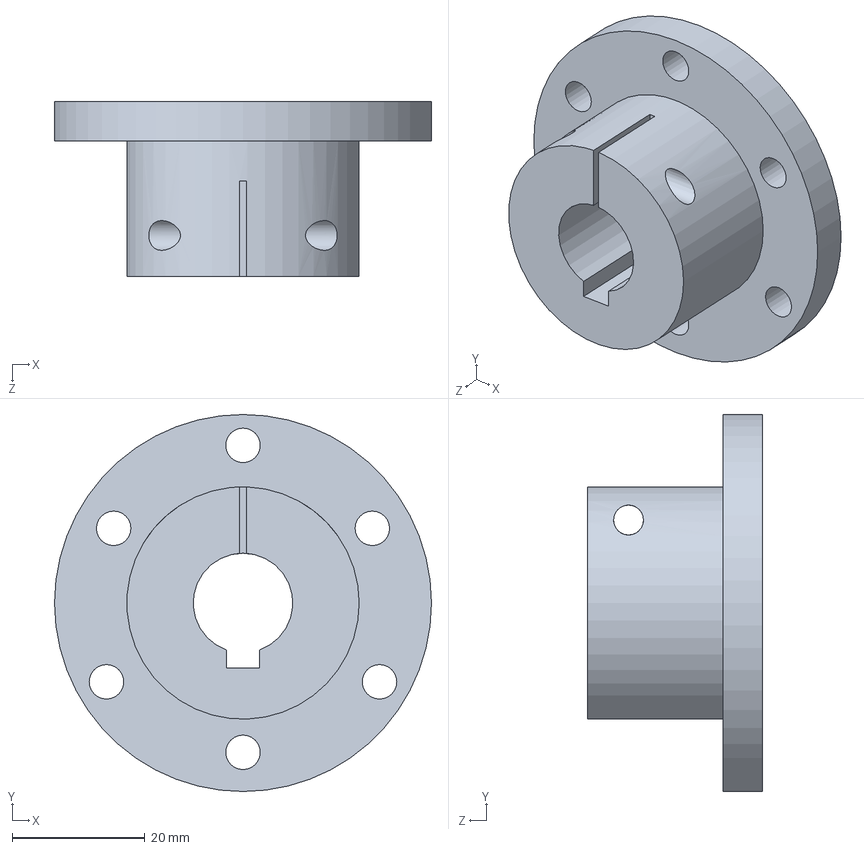
[picture p18: CAD file, 2026-10-31]
機械設計/捲線器/外購件示意/抱緊式法蘭聯軸器_D15.SLDPRT
56.8 x 56.8 x 26.4 mm
