198010ggh-stack/awe_ground/機械設計/捲線器/外購件示意/捲筒軸_D15x200.SLDPRT

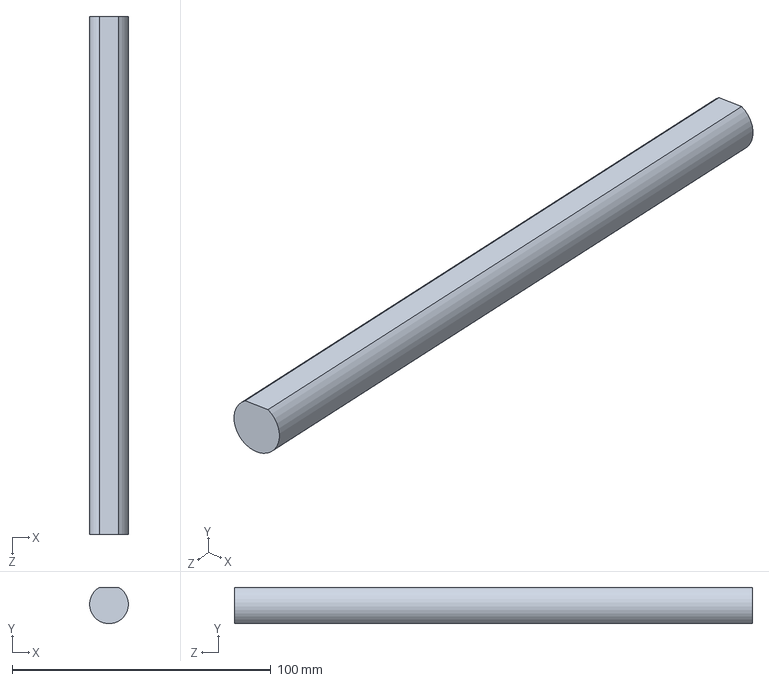
[picture p19: CAD file, 2026-10-31]
機械設計/捲線器/外購件示意/捲筒軸_D15x200.SLDPRT
15.0 x 14.0 x 200.0 mm
