198010ggh-stack/awe_ground/機械設計/捲線器/打印件/卷线器.3mf

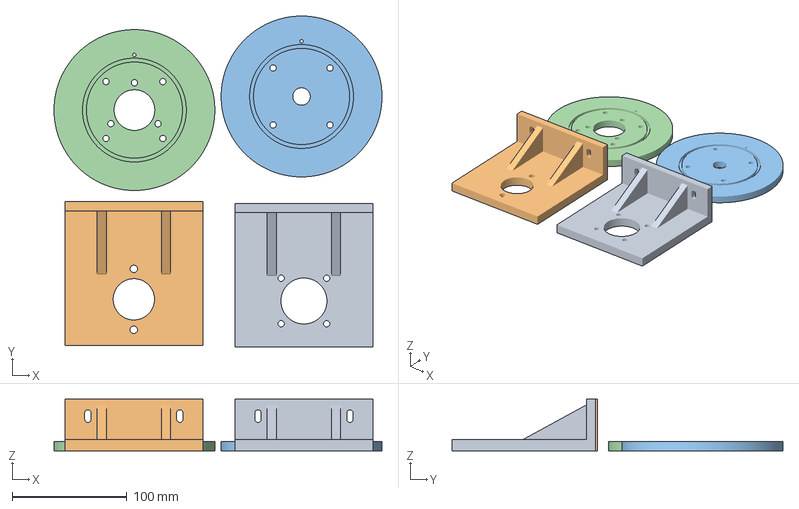
[picture p20: CAD file, 2026-10-31]
機械設計/捲線器/打印件/卷线器.3mf
285.4 x 288.0 x 45.0 mm
立板A_電機座_打1塊.STL
立板BC_軸承座_打2塊.STL
擋板_從動側_打1塊.STL
擋板_驅動側_打1塊.STL
