198010ggh-stack/awe_ground/機械設計/捲線器/外購件示意/聯軸器_爪.SLDPRT

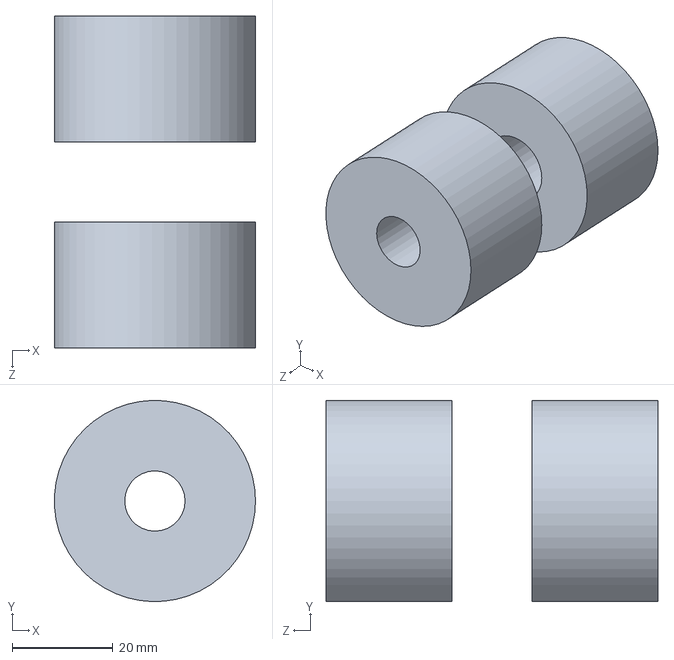
[picture p21: CAD file, 2026-10-31]
機械設計/捲線器/外購件示意/聯軸器_爪.SLDPRT
40.0 x 40.0 x 66.0 mm
