198010ggh-stack/awe_ground/機械設計/捲線器/外購件示意/聯軸器_梅花墊.SLDPRT

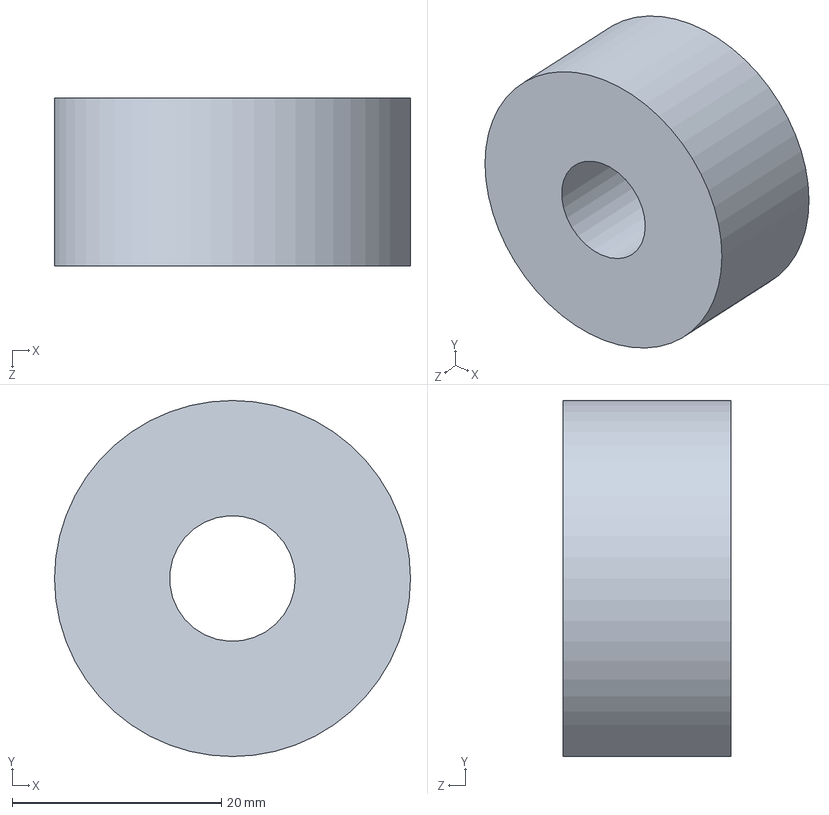
[picture p22: CAD file, 2026-10-31]
機械設計/捲線器/外購件示意/聯軸器_梅花墊.SLDPRT
34.0 x 34.0 x 16.0 mm
