198010ggh-stack/awe_ground/機械設計/捲線器/外購件示意/捲筒芯_6061鋁管_D90x3x68.SLDPRT

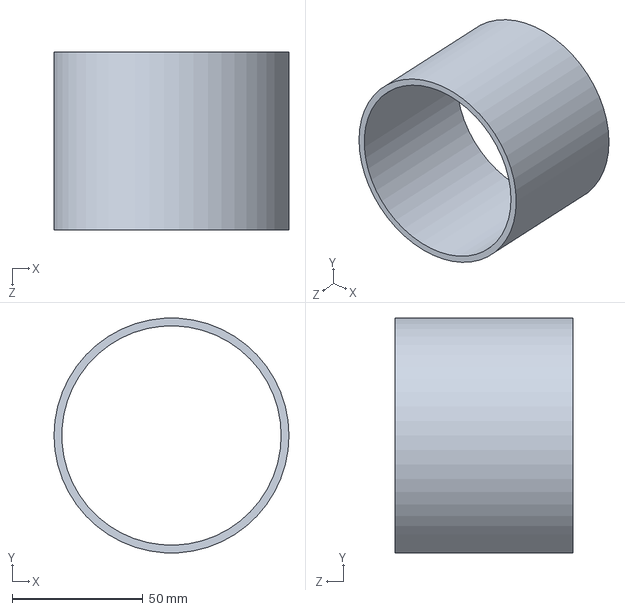
[picture p23: CAD file, 2026-10-31]
機械設計/捲線器/外購件示意/捲筒芯_6061鋁管_D90x3x68.SLDPRT
90.0 x 89.8 x 68.0 mm
