198010ggh-stack/awe_ground/機械設計/捲線器/外購件示意/2020型材x400_x2.SLDPRT

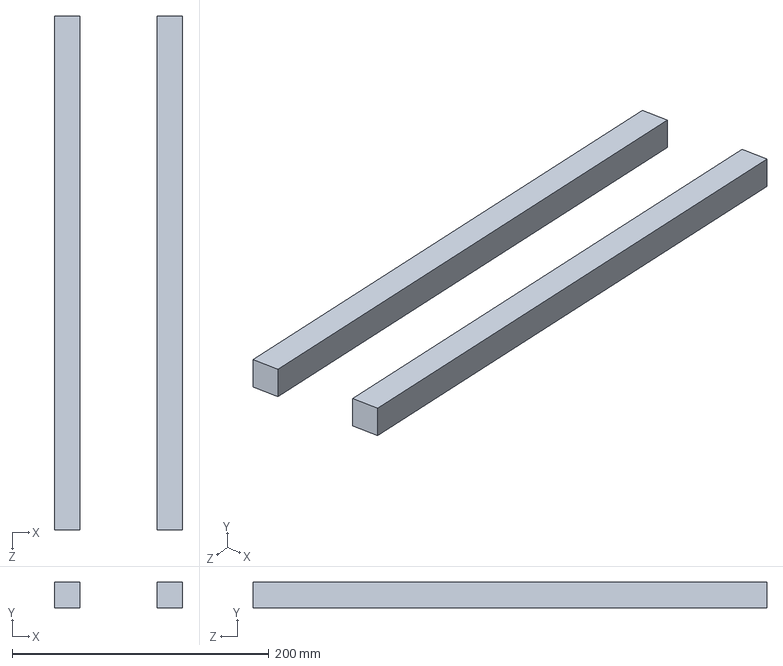
[picture p24: CAD file, 2026-10-31]
機械設計/捲線器/外購件示意/2020型材x400_x2.SLDPRT
100.0 x 20.0 x 400.0 mm
