198010ggh-stack/awe_ground/機械設計/捲線器/外購件示意/M5內六角螺絲x25.SLDPRT

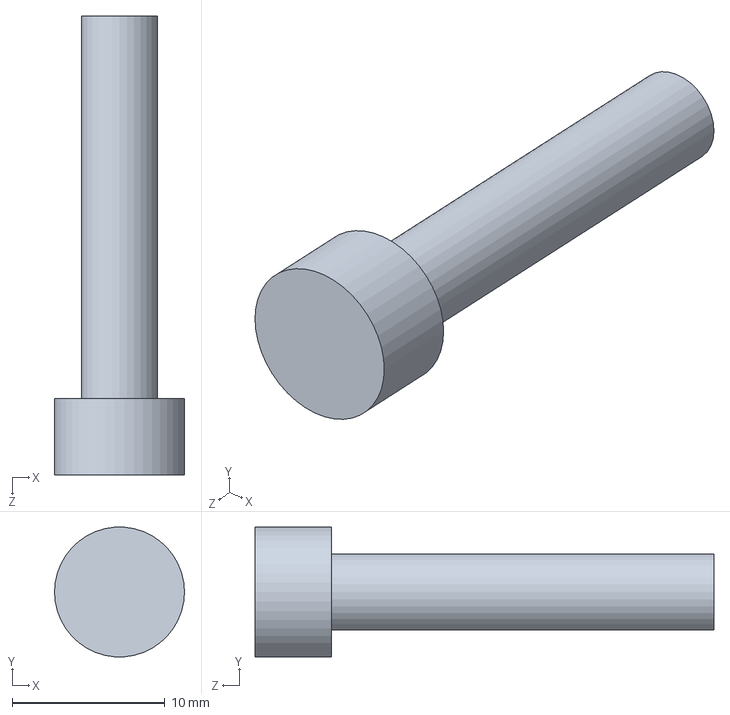
[picture p25: CAD file, 2026-10-31]
機械設計/捲線器/外購件示意/M5內六角螺絲x25.SLDPRT
8.50 x 8.48 x 30.0 mm
