198010ggh-stack/awe_ground/機械設計/捲線器/外購件示意/M5平墊片.SLDPRT

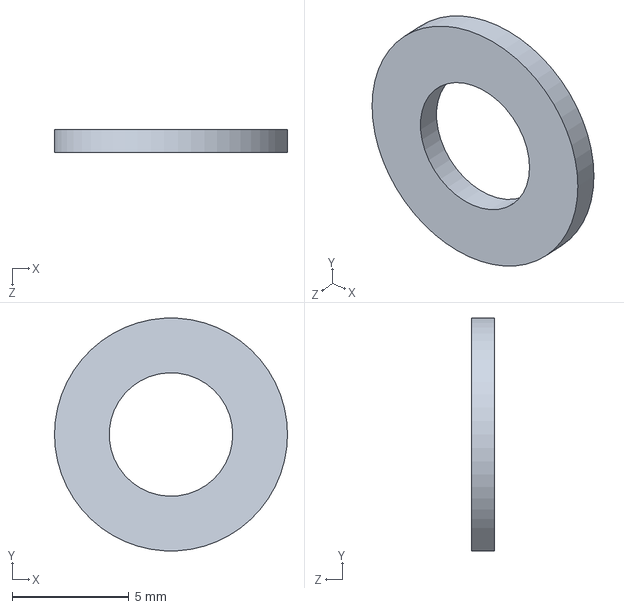
[picture p26: CAD file, 2026-10-31]
機械設計/捲線器/外購件示意/M5平墊片.SLDPRT
10.0 x 9.98 x 1.00 mm
