198010ggh-stack/awe_ground/機械設計/捲線器/外購件示意/M5拉桿x4_L95.SLDPRT

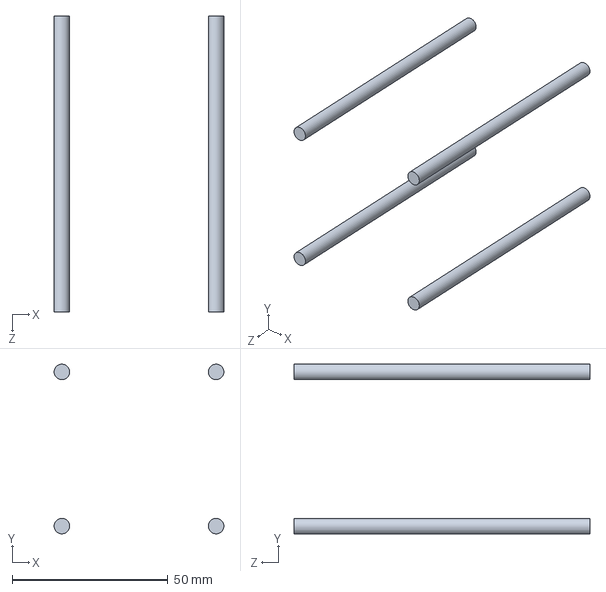
[picture p27: CAD file, 2026-10-31]
機械設計/捲線器/外購件示意/M5拉桿x4_L95.SLDPRT
54.5 x 54.5 x 95.0 mm
