198010ggh-stack/awe_ground/機械設計/捲線器/外購件示意/2020型材x60_橫樑.SLDPRT

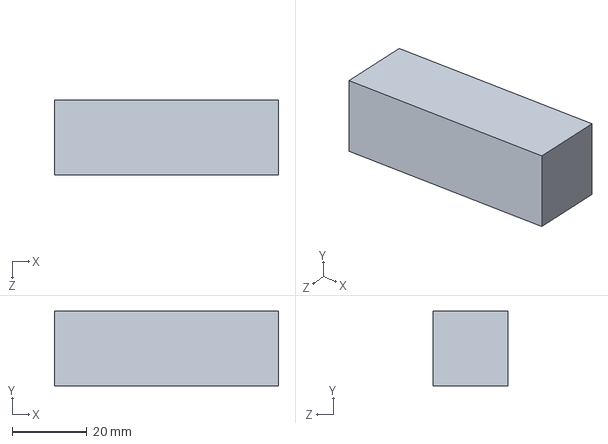
[picture p28: CAD file, 2026-10-31]
機械設計/捲線器/外購件示意/2020型材x60_橫樑.SLDPRT
60.0 x 20.0 x 20.0 mm
