198010ggh-stack/awe_ground/機械設計/捲線器/外購件示意/M6螺母.SLDPRT

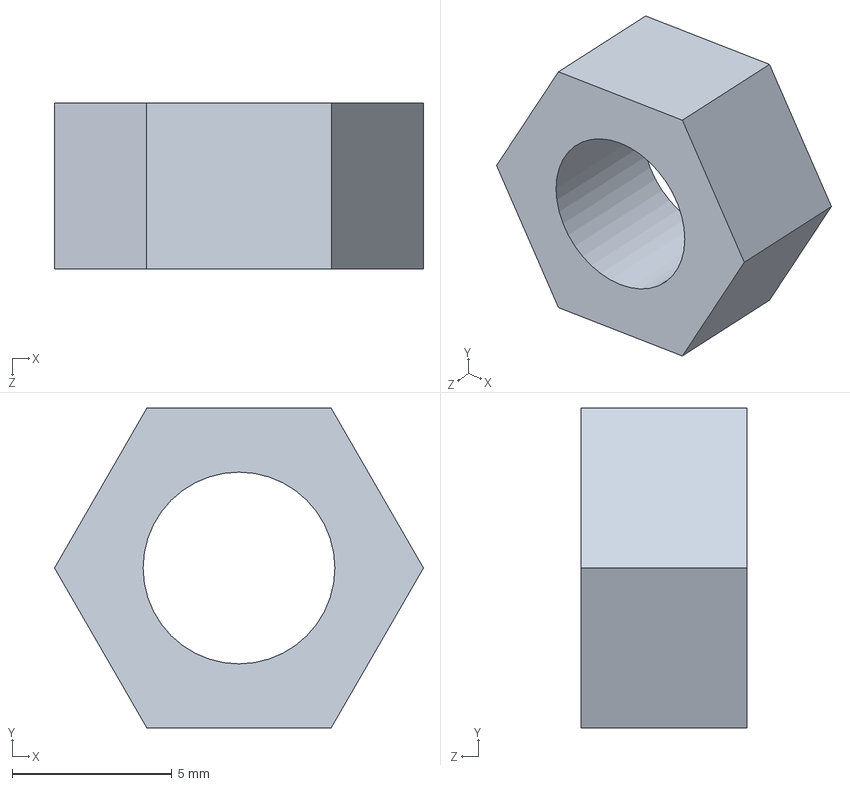
[picture p29: CAD file, 2026-10-31]
機械設計/捲線器/外購件示意/M6螺母.SLDPRT
11.5 x 10.0 x 5.20 mm
