198010ggh-stack/awe_ground/機械設計/捲線器/外購件示意/線_出線段.SLDPRT

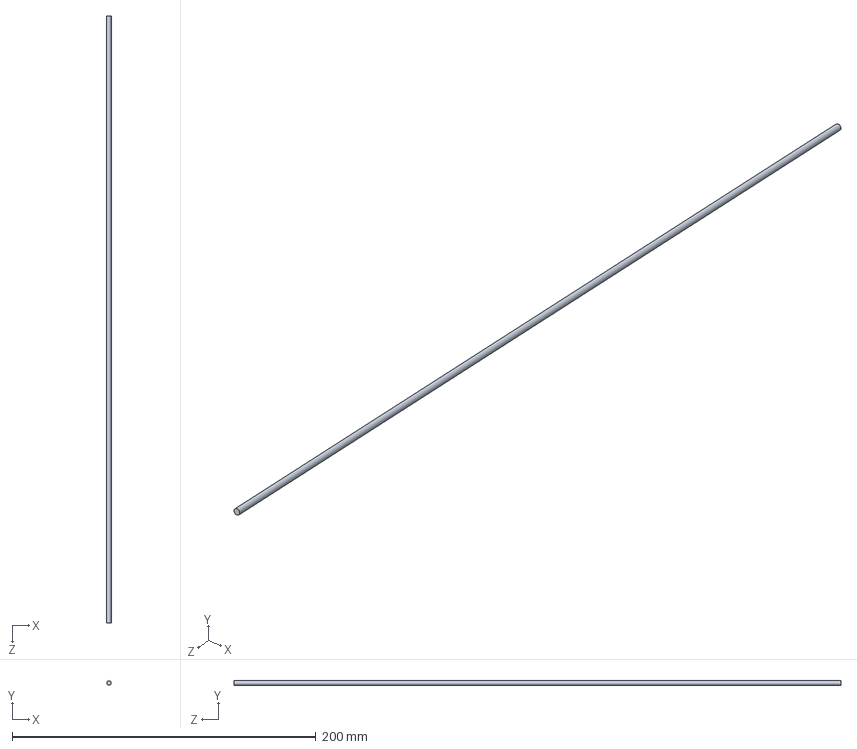
[picture p30: CAD file, 2026-10-31]
機械設計/捲線器/外購件示意/線_出線段.SLDPRT
3.00 x 3.00 x 400.0 mm
