198010ggh-stack/awe_ground/機械設計/捲線器/外購件示意/電機_80100_Kv50.SLDPRT

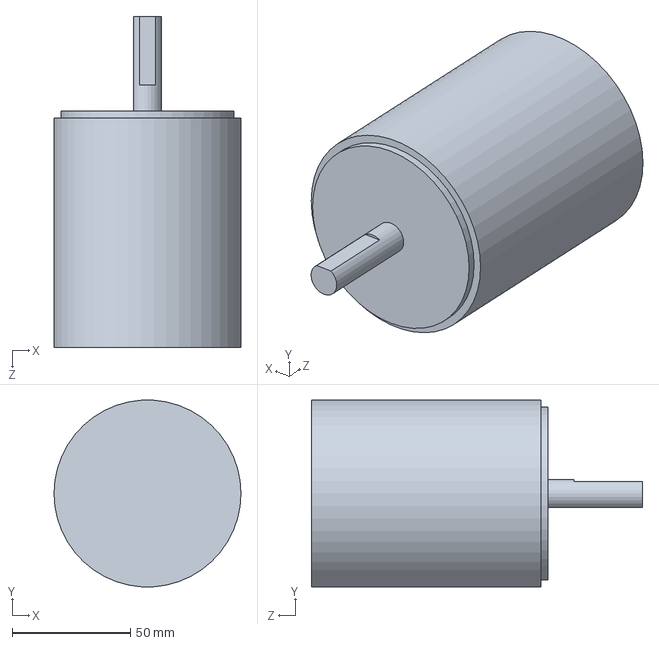
[picture p31: CAD file, 2026-10-31]
機械設計/捲線器/外購件示意/電機_80100_Kv50.SLDPRT
79.0 x 78.8 x 140.0 mm
