198010ggh-stack/awe_ground/機械設計/捲線器/外購件示意/M6內六角螺絲x25.SLDPRT

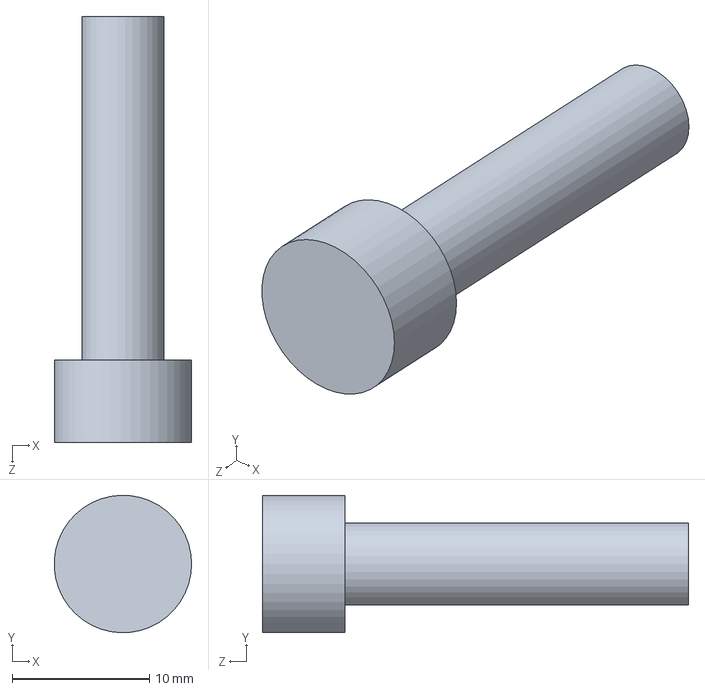
[picture p32: CAD file, 2026-10-31]
機械設計/捲線器/外購件示意/M6內六角螺絲x25.SLDPRT
9.99 x 9.99 x 31.0 mm
