198010ggh-stack/awe_ground/(list of files, cad)

Other CAD files:
機械設計/捲線器/擋板_從動側.SLDPRT
機械設計/捲線器/打印件/擋板_驅動側_打1塊.STL
機械設計/捲線器/立板BC_軸承座.SLDPRT
機械設計/臺架/打印件/滑輪座_打1個.STL
機械設計/臺架/打印件/滑輪_打1個.STL
機械設計/捲線器/打印件/立板A_電機座_打1塊.STL
機械設計/捲線器/立板A_電機座.SLDPRT
機械設計/捲線器/捲線器_總裝.SLDASM
