198010ggh-stack/awe_ground/(commit log)

2026-10-31 捲線器和臺架的機械設計
    - 捲線器：零件和總裝模型、打印 STL、設計文檔、3D 網頁模型、SolidWorks 腳本
    - 臺架：滑輪和滑輪座模型、打印 STL、設計文檔、3D 網頁模型和動圖
    [2020型材x400_x2.SLDPRT, 2020型材x60_橫樑.SLDPRT, KFL002.SLDPRT, M5內六角螺絲x25.SLDPRT, M5加大墊片.SLDPRT, M5尼龍防鬆螺母.SLDPRT, M5平墊片.SLDPRT, M5拉桿x4_L95.SLDPRT]
2026-11-02 臺架改成 v2：滑輪座直接裝在捲線器型材上
    - 滑輪座 v2：立邊頂住近桌邊那根型材，2 顆 M5 擰進側槽；擋線梁改成打印件
    - 去掉橫樑、角碼、F 夾、M4 擋線銷；重物改成水桶裝水
    - 設計文檔、3D 網頁、預覽圖、PPT 動圖和 README 按 v2 更新
    [滑輪座.SLDPRT, 滑輪座_打1個.STL]
2026-11-07 改成地面手拉測試；加六維力傳感器資料和吊板
    - 新增地面手拉測試文檔：固定方法、VESC 電流和轉速限制、口令、標定步驟
    - 臺架暫不搭建，臺架設計文檔加狀態說明；捲線器設計文檔和 README 指向手拉測試
    - HKVL-56C 六維力傳感器使用筆記和讀數腳本，上、下吊板 STL，臺架網頁加傳感器視圖
    - 捲線器設計文檔：捲筒在捲線器上原位對正 D2 再固化
    [上吊板_打1個.STL, 下吊板_打1個.STL]
2026-11-07 加手拉測試 3D 網頁和放線模式動圖
    - 手拉測試網頁：人代替風箏拉線，放線 / 8 字飛行 / 收線三種模式切換，顯示電流、拉力、線速、功率和曲線
    - 放線模式的循環動圖，給 PPT 用
    - README 和地面手拉測試文檔加上網頁和動圖的說明
